huntj88/MicroLights/Casing/casingPrint2Pieces.FCStd

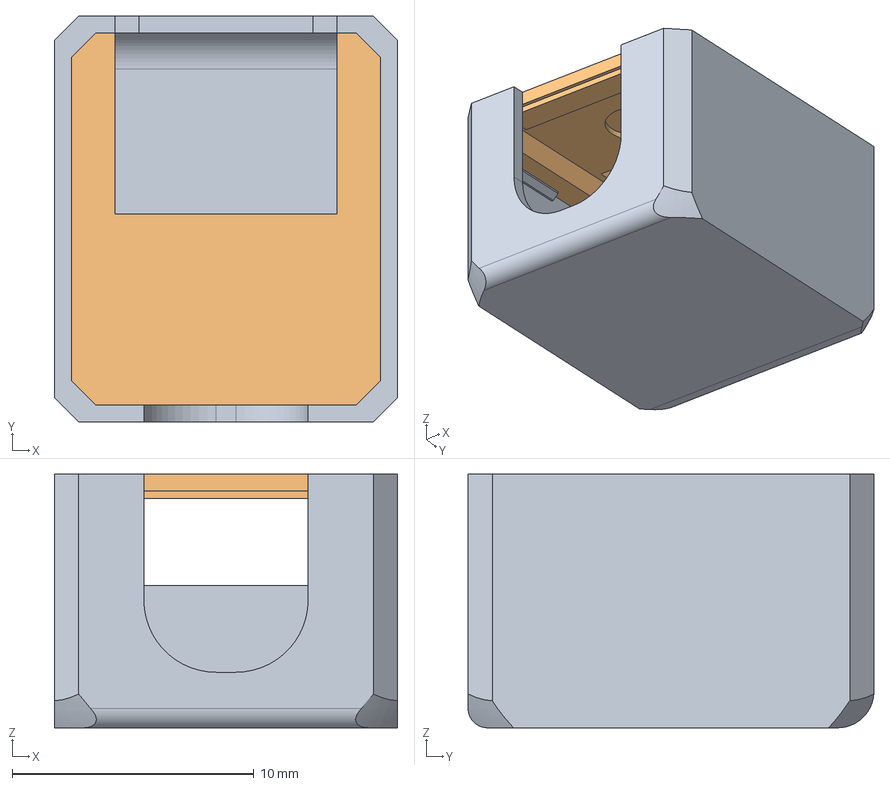
[picture p1: CAD file, 2026-05-08]
Casing/casingPrint2Pieces.FCStd
14.2 x 16.8 x 10.5 mm
