huntj88/MicroLights/Casing/casingPrint2Pieces-bottomCasing17.3mf

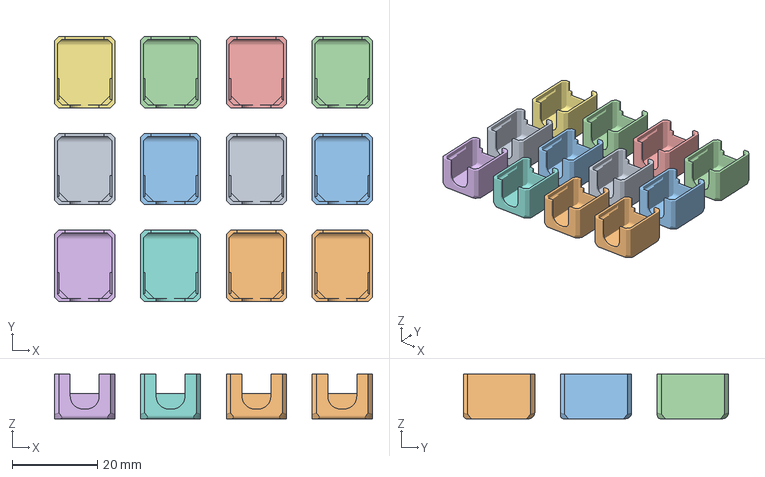
[picture p2: CAD file, 2026-05-08]
Casing/casingPrint2Pieces-bottomCasing17.3mf
74.8 x 62.4 x 10.5 mm
