huntj88/MicroLights/Casing/casingPrint2Pieces-topCasing17.3mf

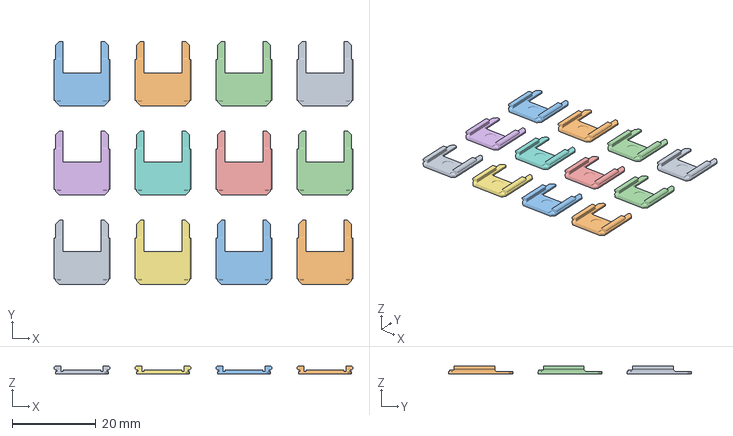
[picture p3: CAD file, 2026-05-08]
Casing/casingPrint2Pieces-topCasing17.3mf
71.6 x 58.2 x 2.00 mm
