huntj88/MicroLights/Casing/JigBendLED.FCStd

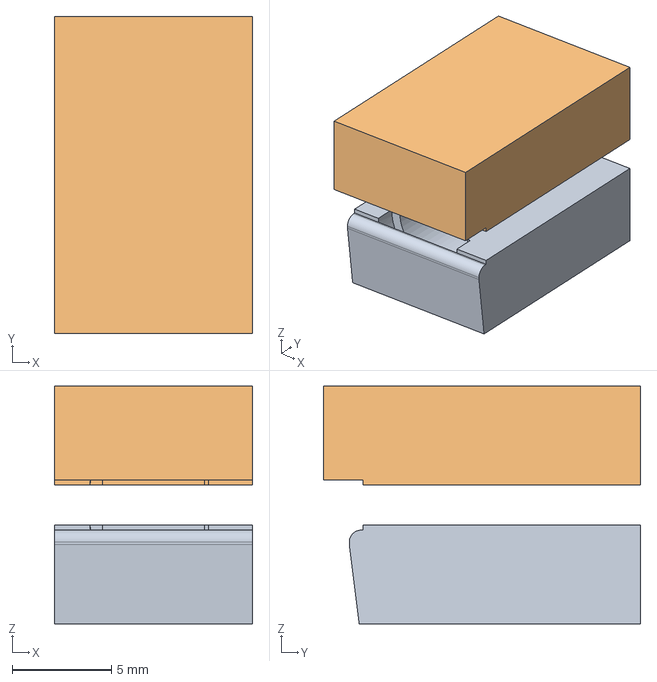
[picture p4: CAD file, 2026-05-04]
Casing/JigBendLED.FCStd
10.0 x 16.0 x 12.0 mm
