huntj88/MicroLights/Casing/bulbJig.FCStd

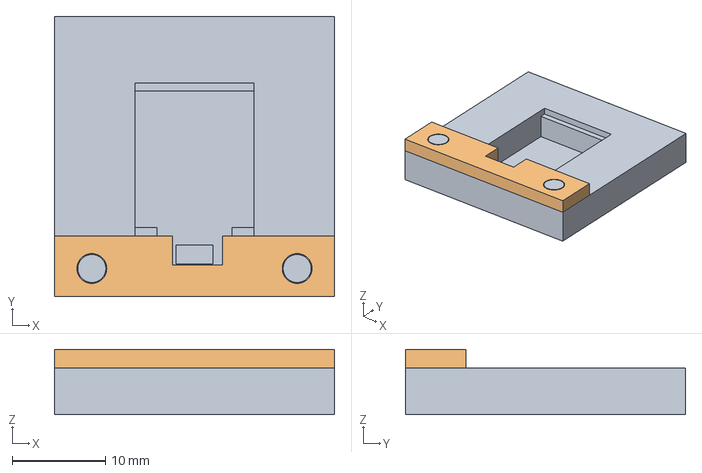
[picture p5: CAD file, 2026-05-04]
Casing/bulbJig.FCStd
30.0 x 30.0 x 7.00 mm
