huntj88/MicroLights/Casing/CasingMoldV2.FCStd

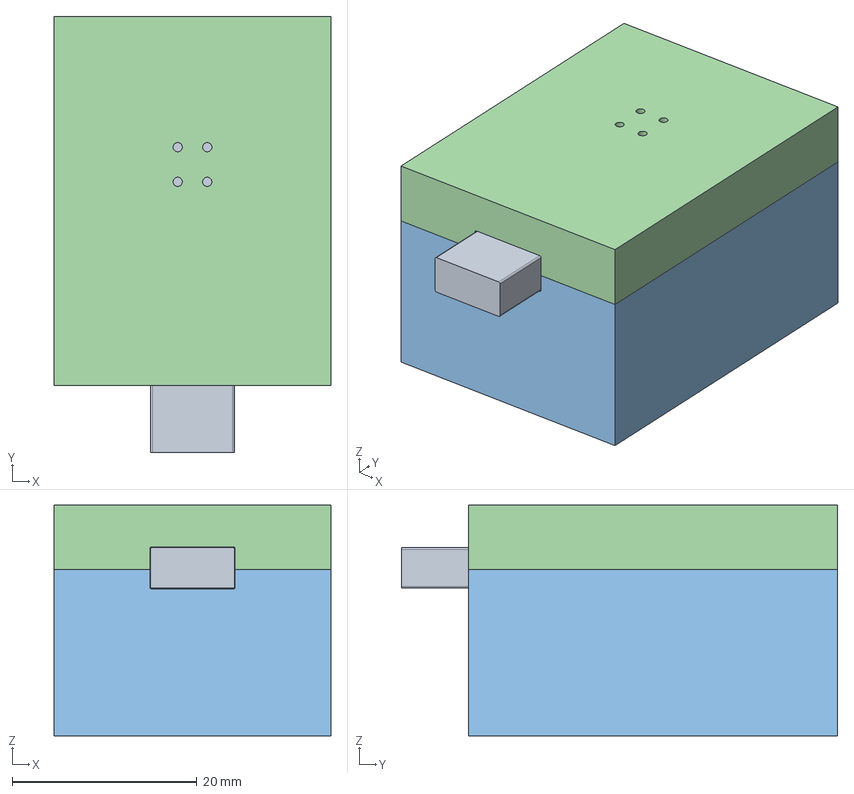
[picture p6: CAD file, 2025-08-21]
Casing/CasingMoldV2.FCStd
30.0 x 47.2 x 25.0 mm
