huntj88/MicroLights/Casing/CasingMold.FCStd

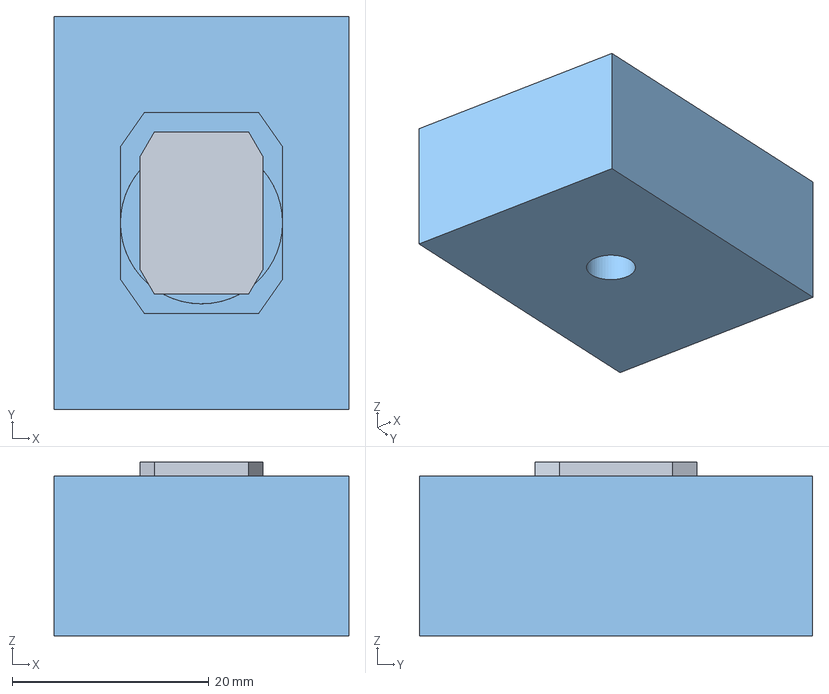
[picture p7: CAD file, 2025-08-16, an earlier design]
Casing/CasingMold.FCStd
30.0 x 40.0 x 17.7 mm
