huntj88/MicroLights/(list of files, cad)

Other CAD files:
Casing/casingPrint2Pieces-bottomCasing17.stl
Casing/casingPrint2Pieces-topCasing17.stl
