huntj88/MicroLights/MicroLightDevBoardV3/MicroLightDevBoardV3.kicad_pcb

## KiCad design MicroLightDevBoardV3/MicroLightDevBoardV3.kicad_pcb (2026-04-19)

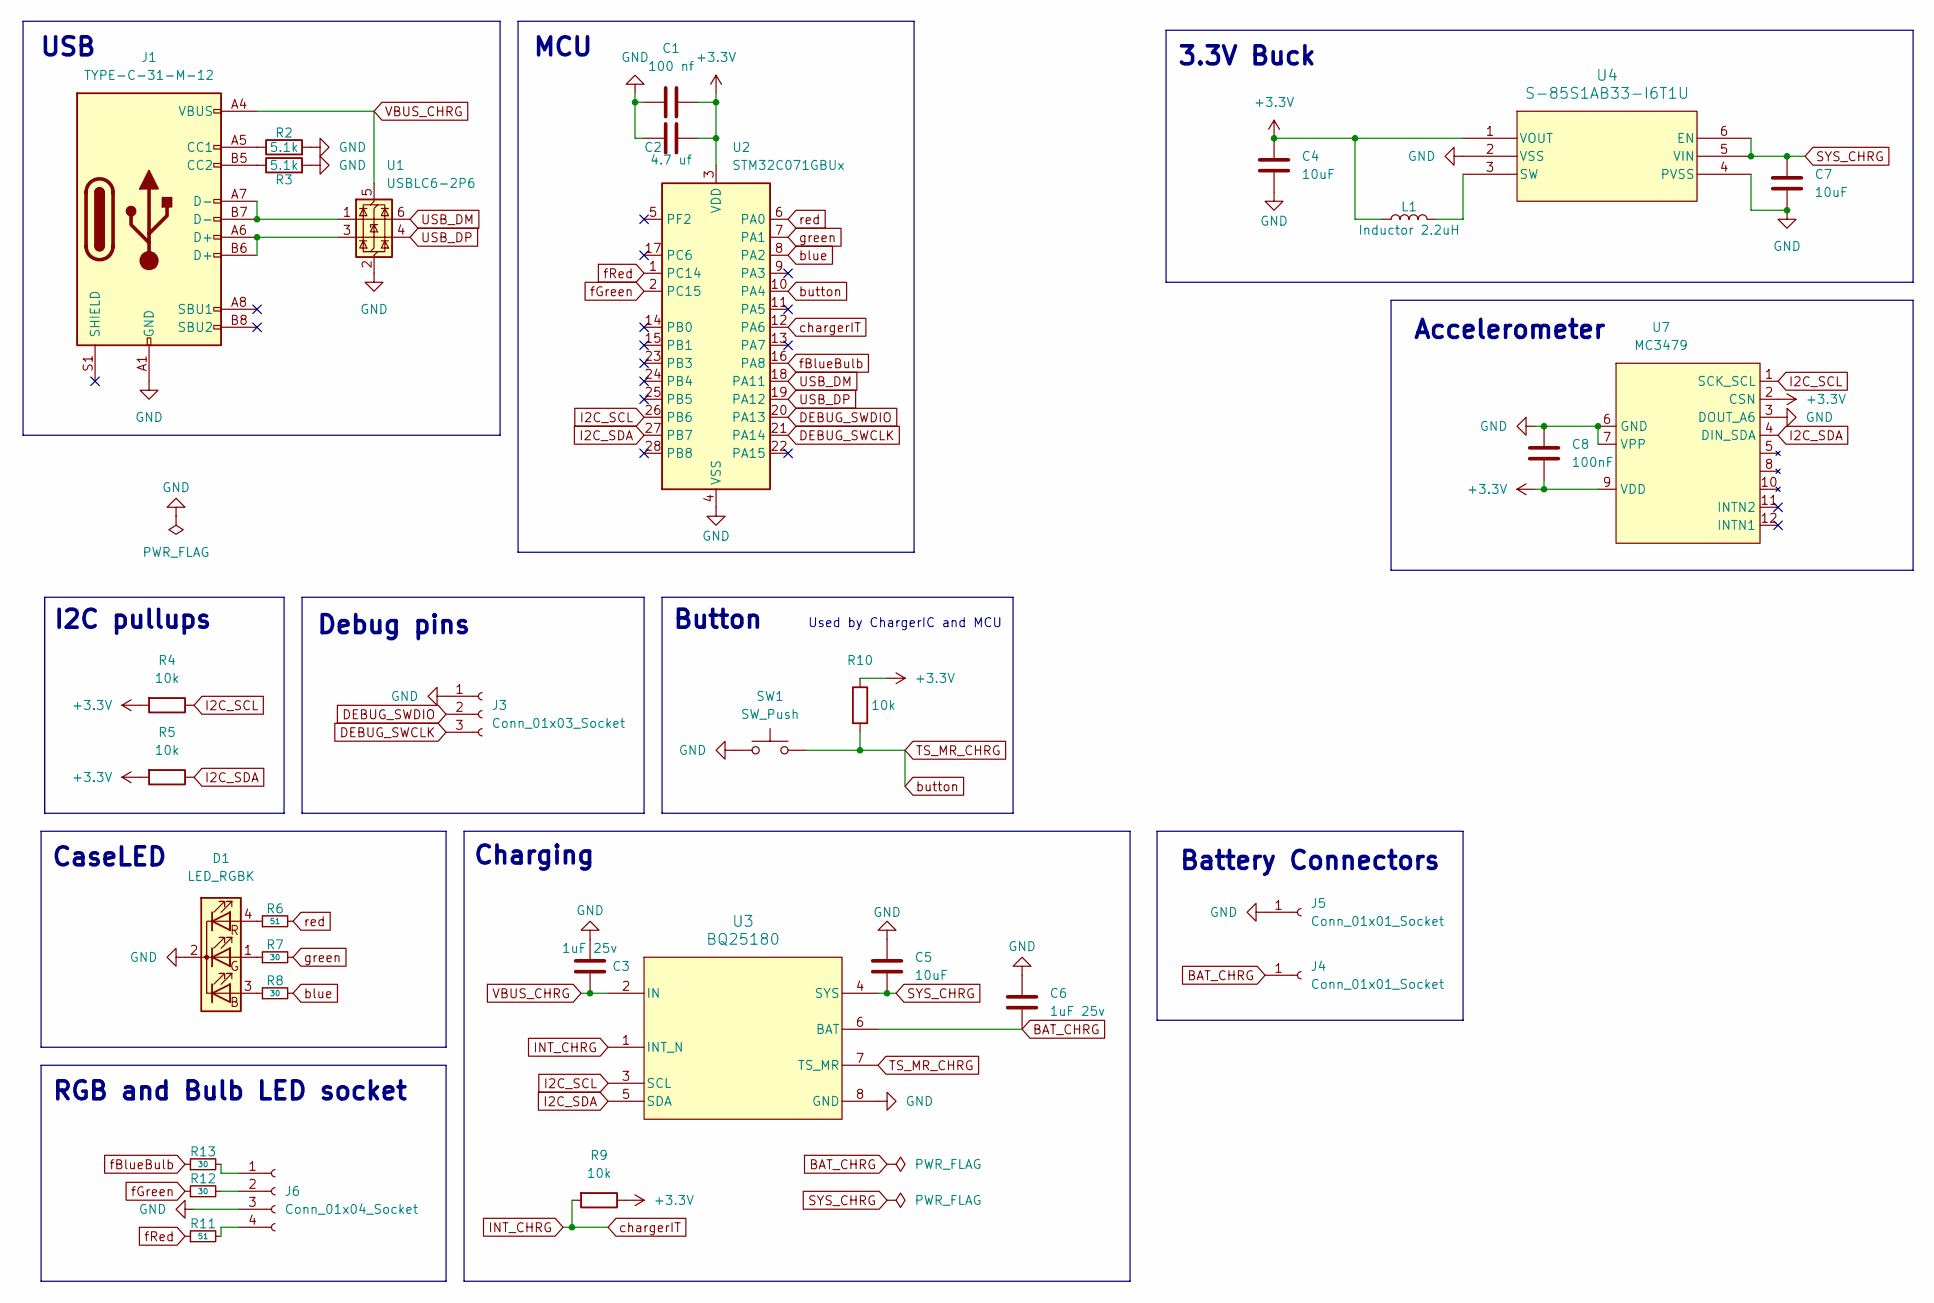
[picture p8: schematic MicroLightDevBoardV3.kicad_sch]

Parts:
C1: 100 nf; C_0402_1005Metric; LCSC C1525
C2: 4.7 uf; C_0402_1005Metric; LCSC C23733
C3, C6: 1uF 25v; C_0402_1005Metric; LCSC C52923
C4, C5, C7: 10uF; C_0402_1005Metric; LCSC C15525
C8: 100nF; C_0402_1005Metric; LCSC C1525
D1: LED_RGBK; RS-C1415MBAR; LCSC C2874181
J1: TYPE-C-31-M-12; USB_C_Receptacle_Hroparts_TYPE-C-31-M-12; LCSC C165948
J3: Conn_01x03_Socket; Microlight_debug_pins
J4, J5: Conn_01x01_Socket; battery_1x01_Vertical
J6: Conn_01x04_Socket; rgbLed4Pin_1.27mm
L1: Inductor 2.2uH; 74438343022_L; LCSC C337891
R2, R3: 5.1k; R_0402_1005Metric; LCSC C25905
R4, R5, R9, R10: 10k; R_0402_1005Metric; LCSC C25744
R6, R11: 51; R_0402_1005Metric; LCSC C25125
R7, R8, R12, R13: 30; R_0402_1005Metric; LCSC C270617
SW1: SW_Push; TS-1089S-02526; LCSC C455282
U1: USBLC6-2P6; SOT-666; LCSC C3647099
U2: STM32C071GBUx; QFN-28_4x4mm_P0.5mm; LCSC C42113261
U3: BQ25180; LCSC C3682423
U4: S-85S1AB33-I6T1U; SNT-6A-A-PKG_PG006-A-P-SD-2.1_ABL; LCSC C7070110
U7: MC3479; LGA-12_2x2mm_P0.5mm

Connections:
+3.3V: C1.1, C2.1, C4.1, C8.2, L1.1, R4.2, R5.2, R9.1, R10.1, U2.3 (VDD), U4.1 (VOUT), U7.2 (CSN), U7.9 (VDD)
BAT_CHRG: C6.2, J4.1, U3.6 (BAT)
DEBUG_SWCLK: J3.3, U2.21 (PA14)
DEBUG_SWDIO: J3.2, U2.20 (PA13)
GND: C1.2, C2.2, C3.1, C4.2, C5.1, C6.1, C7.2, C8.1, D1.2 (K), J1.A1 (GND), J1.B1 (GND), J3.1, J5.1, J6.3, R2.2, R3.2, SW1.1, U1.2 (GND), U2.4 (VSS), U3.8 (GND), U4.2 (VSS), U4.4 (PVSS), U7.3 (DOUT_A6), U7.6 (GND), U7.7 (VPP)
I2C_SCL: R4.1, U2.26 (PB6), U3.3 (SCL), U7.1 (SCK_SCL)
I2C_SDA: R5.1, U2.27 (PB7), U3.5 (SDA), U7.4 (DIN_SDA)
INT_CHRG: R9.2, U2.12 (PA6), U3.1 (INT_N)
unnamed: D1.3 (BA), R8.1
unnamed: D1.1 (GA), R7.1
unnamed: D1.4 (RA), R6.1
unnamed: J1.A5 (CC1), R2.1
unnamed: J1.B5 (CC2), R3.1
unnamed: J1.A6 (D+), J1.B6 (D+), U1.3 (I/O2)
unnamed: J1.A7 (D-), J1.B7 (D-), U1.1 (I/O1)
unnamed: J6.1, R13.2
unnamed: J6.2, R12.2
unnamed: J6.4, R11.2
unnamed: L1.2, U4.3 (SW)
SYS_CHRG: C5.2, C7.1, U3.4 (SYS), U4.5 (VIN), U4.6 (EN)
TS_MR_CHRG: R10.2, SW1.2, U2.10 (PA4), U3.7 (TS_MR)
USB_DM: U1.6 (I/O1), U2.18 (PA11)
USB_DP: U1.4 (I/O2), U2.19 (PA12)
VBUS_CHRG: C3.2, J1.A4 (VBUS), J1.B4 (VBUS), U1.5 (VBUS), U3.2 (IN)
blue: R8.2, U2.8 (PA2)
fBlueBulb: R13.1, U2.16 (PA8)
fGreen: R12.1, U2.2 (PC15)
fRed: R11.1, U2.1 (PC14)
green: R7.2, U2.7 (PA1)
red: R6.2, U2.6 (PA0)

Notes on the sheet:
Used by ChargerIC and MCU
I2C pullups
CaseLED
RGB and Bulb LED socket
USB
Charging
3.3V Buck
Accelerometer
Battery Connectors
Debug pins
Button
MCU

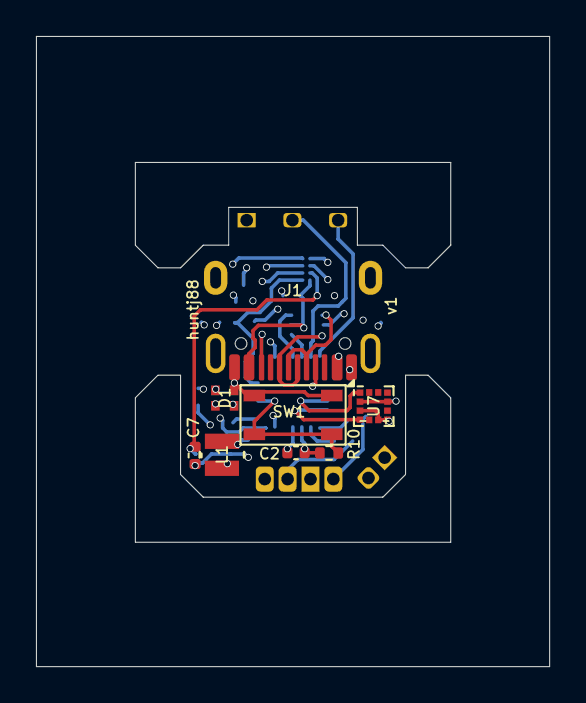
[picture p9: board MicroLightDevBoardV3.kicad_pcb from above]

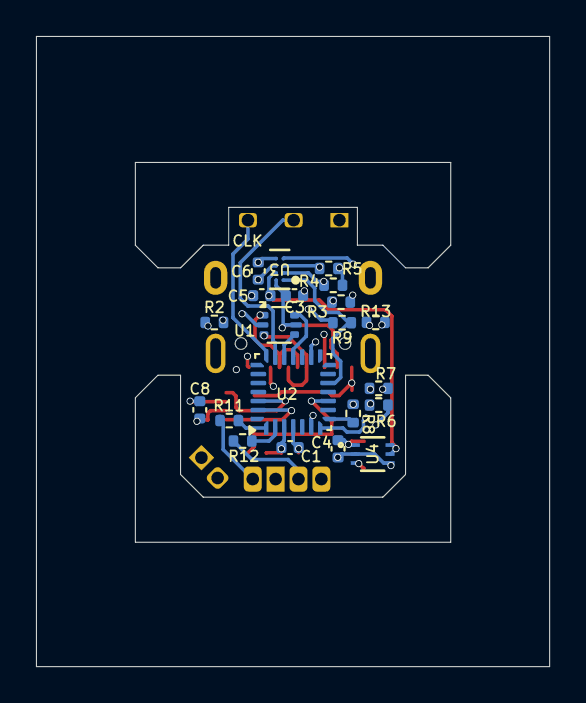
[picture p10: board MicroLightDevBoardV3.kicad_pcb from below]

Board: 6 copper layers, 28.5 x 35.0 mm, 33 parts (21 on the bottom side), 30 nets.
