huntj88/MicroLights/BQ25180PCB/BQ25180PCB.kicad_pcb

## KiCad design BQ25180PCB/BQ25180PCB.kicad_pcb (2024-11-12)

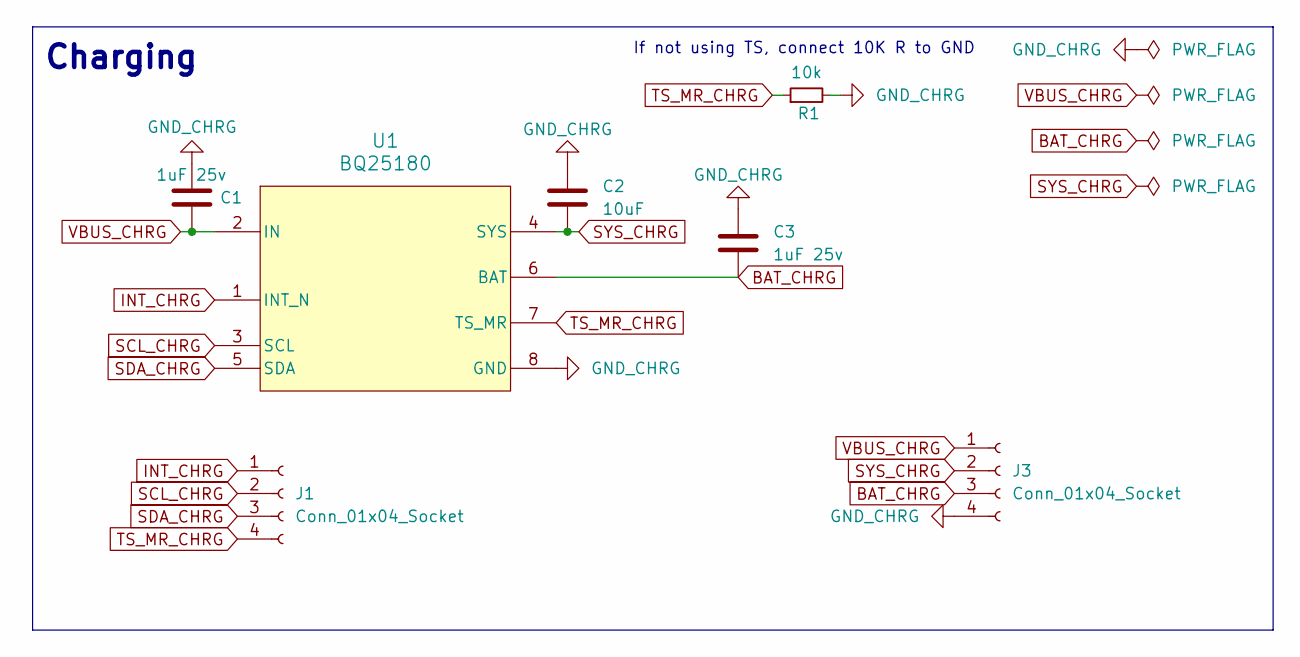
[picture p11: schematic BQ25180PCB.kicad_sch]

Parts:
C1, C3: 1uF 25v; C_0805_2012Metric; LCSC C1712
C2: 10uF; C_0805_2012Metric; LCSC C15850
J1, J3: Conn_01x04_Socket; PinSocket_1x04_P2.54mm_Vertical; LCSC C2718488
R1: 10k; R_0805_2012Metric; LCSC C17414
U1: BQ25180; LCSC C3682423

Connections:
BAT_CHRG: C3.2, J3.3, U1.6 (BAT)
GND_CHRG: C1.1, C2.1, C3.1, J3.4, R1.2, U1.8 (GND)
INT_CHRG: J1.1, U1.1 (INT_N)
SCL_CHRG: J1.2, U1.3 (SCL)
SDA_CHRG: J1.3, U1.5 (SDA)
SYS_CHRG: C2.2, J3.2, U1.4 (SYS)
TS_MR_CHRG: J1.4, R1.1, U1.7 (TS_MR)
VBUS_CHRG: C1.2, J3.1, U1.2 (IN)

Notes on the sheet:
If not using TS, connect 10K R to GND
Charging

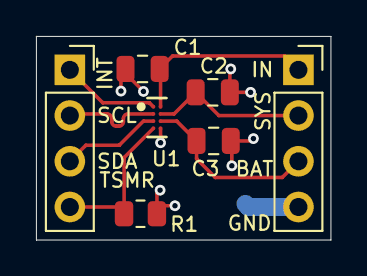
[picture p12: board BQ25180PCB.kicad_pcb from above]

Board: 2 copper layers, 16.4 x 11.3 mm, 7 parts (0 on the bottom side), 8 nets.
