huntj88/MicroLights/MicroLightDevBoardV2/MicroLightDevBoardV2.kicad_pcb

## KiCad design MicroLightDevBoardV2/MicroLightDevBoardV2.kicad_pcb (2024-09-16, an earlier design)

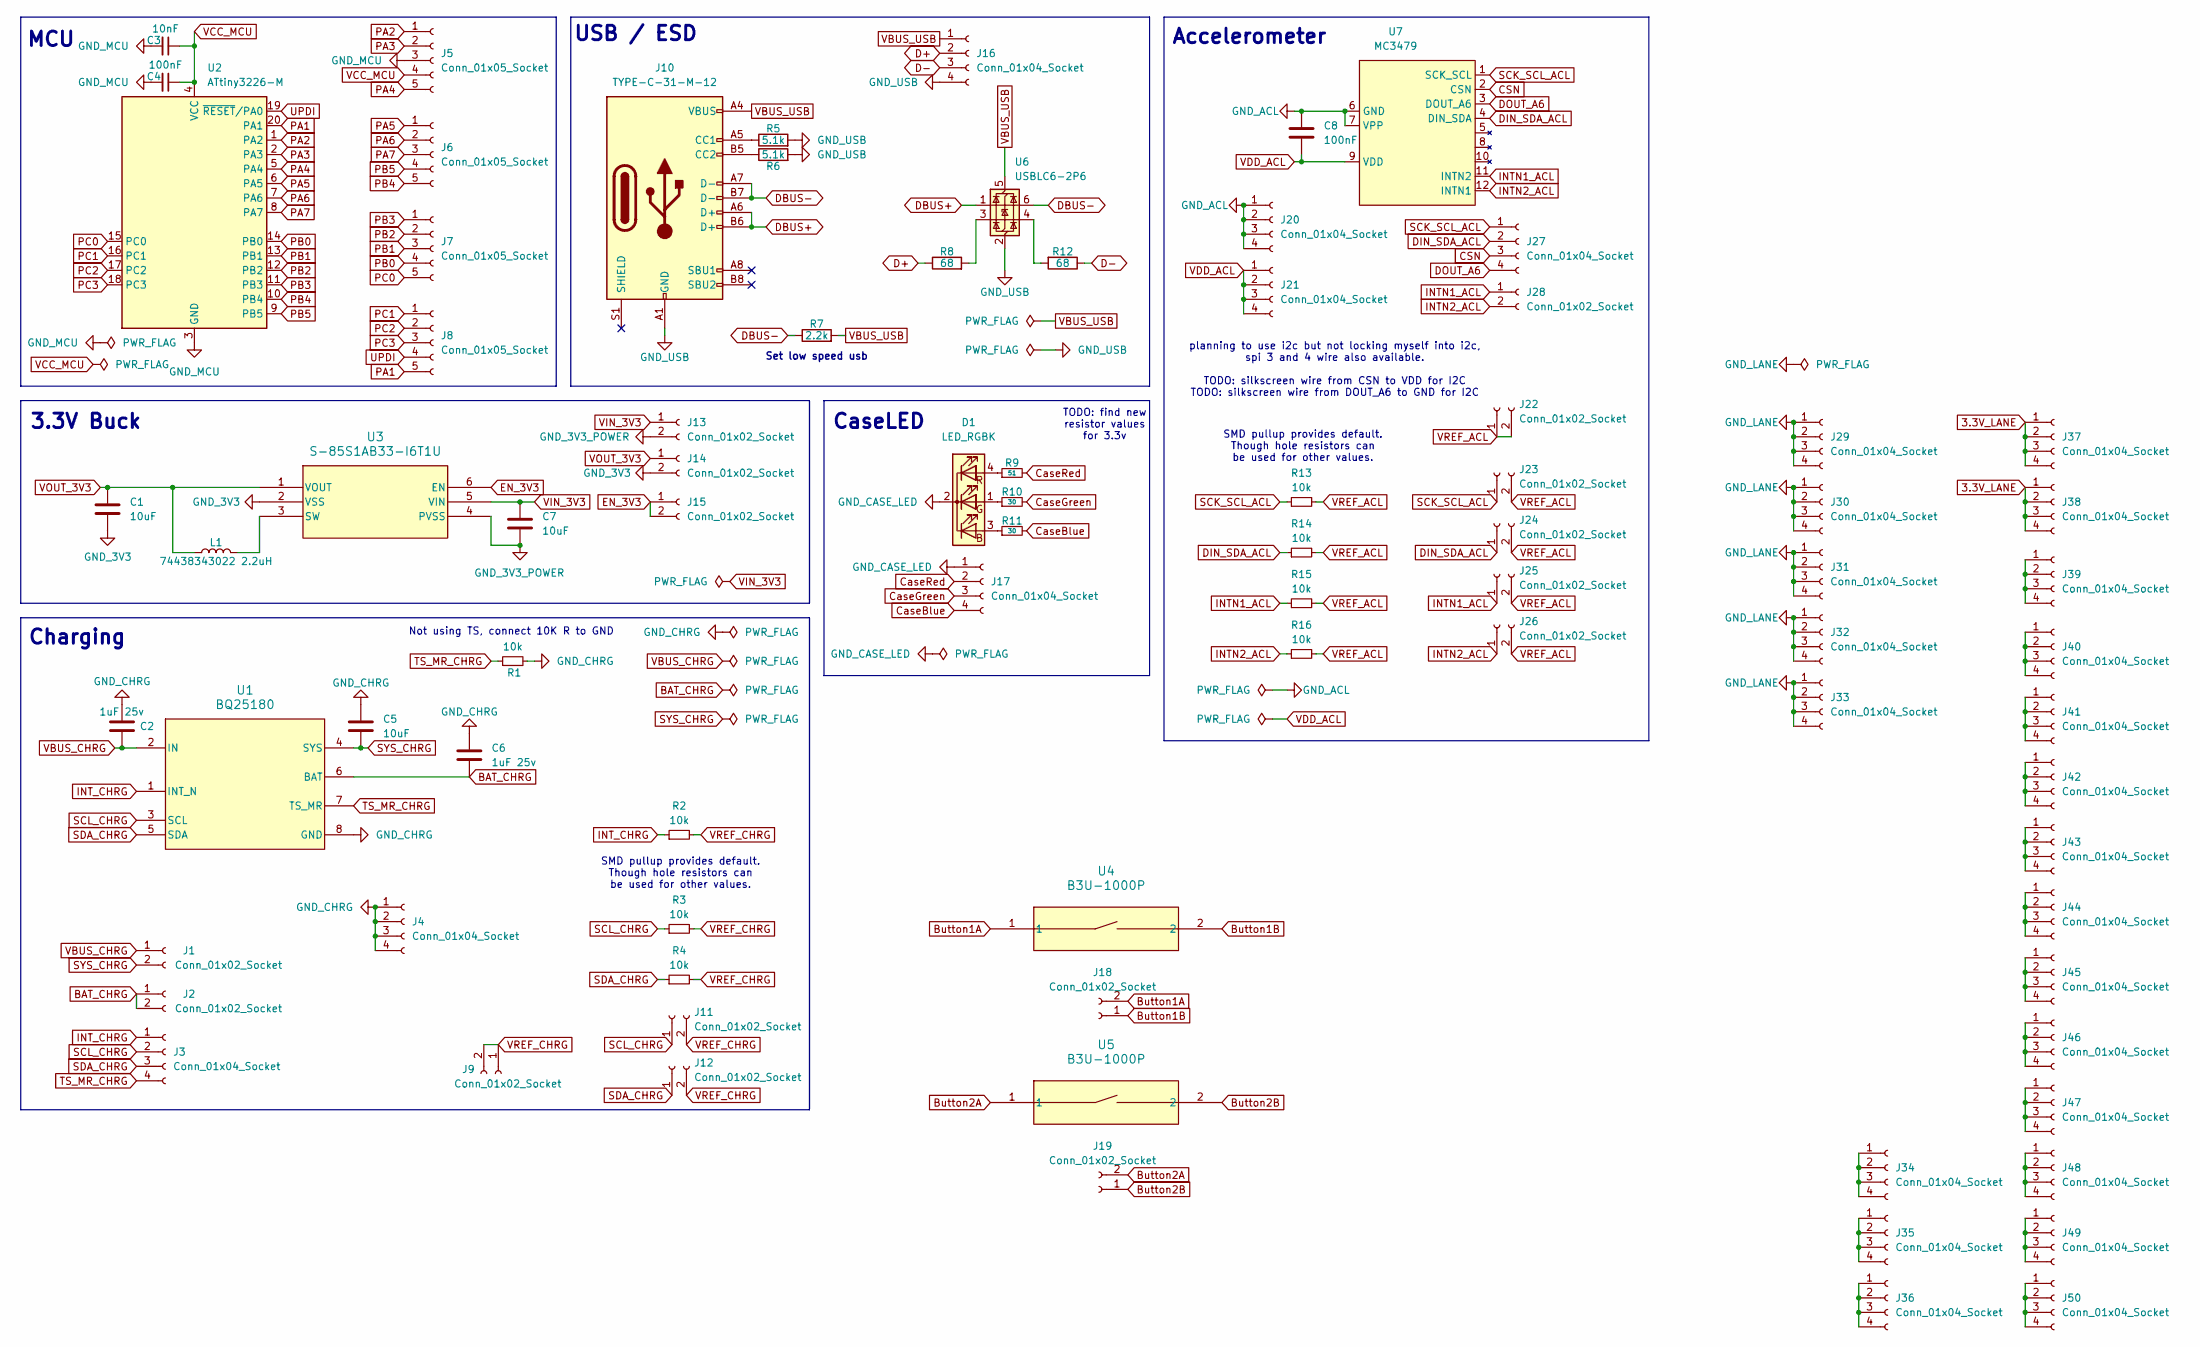
[picture p13: schematic MicroLightDevBoardV2.kicad_sch]

Parts:
C1, C5, C7: 10uF; C_0603_1608Metric; LCSC C96446
C2, C6: 1uF 25v; C_0603_1608Metric; LCSC C15849
C3: 10nF; C_0603_1608Metric; LCSC C57112
C4, C8: 100nF; C_0603_1608Metric; LCSC C14663
D1: LED_RGBK; RS-C1415MBAR; LCSC C2874181
J1, J2, J9, J11, J12, J13, J14, J15, J18, J19, J22, J23, J24, J25, J26, J28: Conn_01x02_Socket; PinSocket_1x02_P2.54mm_Vertical; LCSC C49661
J3, J4, J16, J17, J20, J21, J27, J29, J30, J31, J32, J33, J34, J35, J36, J37, J38, J39, J40, J41, J42, J43, J44, J45, J46, J47, J48, J49, J50: Conn_01x04_Socket; PinSocket_1x04_P2.54mm_Vertical; LCSC C2718488
J5, J6, J7, J8: Conn_01x05_Socket; PinSocket_1x05_P2.54mm_Vertical; LCSC C50950
J10: TYPE-C-31-M-12; USB_C_Receptacle_Hroparts_TYPE-C-31-M-12; LCSC C165948
L1: 74438343022 2.2uH; 74438343022_L
R1, R2, R3, R4, R13, R14, R15, R16: 10k; R_0603_1608Metric; LCSC C25804
R5, R6: 5.1k; R_0603_1608Metric; LCSC C23186
R7: 2.2k; R_0603_1608Metric; LCSC C4190
R8, R12: 68; R_0603_1608Metric; LCSC C27592
R9: 51; R_0603_1608Metric; LCSC C23197
R10, R11: 30; R_0603_1608Metric; LCSC C23140
U1: BQ25180; LCSC C3682423
U2: ATtiny3226-M; VQFN-20-1EP_3x3mm_P0.4mm_EP1.7x1.7mm
U3: S-85S1AB33-I6T1U; SNT-6A-A-PKG_PG006-A-P-SD-2.1_ABL
U4, U5: B3U-1000P; LCSC C231329
U6: USBLC6-2P6; SOT-666; LCSC C15999
U7: MC3479; LGA-12_2x2mm_P0.5mm

Connections:
3.3V_LANE: J37.1, J37.2, J37.3, J37.4, J38.1, J38.2, J38.3, J38.4
BAT_CHRG: C6.2, J2.1, J2.2, U1.6 (BAT)
Button1A: J18.2, U4.1
Button1B: J18.1, U4.2
Button2A: J19.2, U5.1
Button2B: J19.1, U5.2
CSN: J27.3, U7.2 (CSN)
CaseBlue: J17.4, R11.2
CaseGreen: J17.3, R10.2
CaseRed: J17.2, R9.2
D+: J16.2, R8.1
D-: J16.3, R12.1
DBUS+: J10.A6 (D+), J10.B6 (D+), U6.1 (I/O1)
DBUS-: J10.A7 (D-), J10.B7 (D-), R7.1, U6.6 (I/O1)
DIN_SDA_ACL: J24.1, J27.2, R14.1, U7.4 (DIN_SDA)
DOUT_A6: J27.4, U7.3 (DOUT_A6)
EN_3V3: J15.1, J15.2, U3.6 (EN)
GND_3V3: C1.2, J14.2, U3.2 (VSS)
GND_3V3_POWER: C7.2, J13.2, U3.4 (PVSS)
GND_ACL: C8.1, J20.1, J20.2, J20.3, J20.4, U7.6 (GND), U7.7 (VPP)
GND_CASE_LED: D1.2 (K), J17.1
GND_CHRG: C2.1, C5.1, C6.1, J4.1, J4.2, J4.3, J4.4, R1.2, U1.8 (GND)
GND_LANE: J29.1, J29.2, J29.3, J29.4, J30.1, J30.2, J30.3, J30.4, J31.1, J31.2, J31.3, J31.4, J32.1, J32.2, J32.3, J32.4, J33.1, J33.2, J33.3, J33.4
GND_MCU: C3.2, C4.2, J5.3, U2.3 (GND), U2.21 (GND)
GND_USB: J10.A1 (GND), J10.B1 (GND), J16.4, R5.2, R6.2, U6.2 (GND)
INTN1_ACL: J25.1, J28.1, R15.1, U7.11 (INTN2)
INTN2_ACL: J26.1, J28.2, R16.1, U7.12 (INTN1)
INT_CHRG: J3.1, R2.1, U1.1 (INT_N)
unnamed: D1.3 (BA), R11.1
unnamed: D1.1 (GA), R10.1
unnamed: D1.4 (RA), R9.1
unnamed: J10.A5 (CC1), R5.1
unnamed: J10.B5 (CC2), R6.1
unnamed: J34.1, J34.2, J34.3, J34.4
unnamed: J35.1, J35.2, J35.3, J35.4
unnamed: J36.1, J36.2, J36.3, J36.4
unnamed: J39.1, J39.2, J39.3, J39.4
unnamed: J40.1, J40.2, J40.3, J40.4
unnamed: J41.1, J41.2, J41.3, J41.4
unnamed: J42.1, J42.2, J42.3, J42.4
unnamed: J43.1, J43.2, J43.3, J43.4
unnamed: J44.1, J44.2, J44.3, J44.4
unnamed: J45.1, J45.2, J45.3, J45.4
unnamed: J46.1, J46.2, J46.3, J46.4
unnamed: J47.1, J47.2, J47.3, J47.4
unnamed: J48.1, J48.2, J48.3, J48.4
unnamed: J49.1, J49.2, J49.3, J49.4
unnamed: J50.1, J50.2, J50.3, J50.4
unnamed: R8.2, U6.3 (I/O2)
unnamed: R12.2, U6.4 (I/O2)
unnamed: L1.2, U3.3 (SW)
PA1: J8.5, U2.20 (PA1)
PA2: J5.1, U2.1 (PA2)
PA3: J5.2, U2.2 (PA3)
PA4: J5.5, U2.5 (PA4)
PA5: J6.1, U2.6 (PA5)
PA6: J6.2, U2.7 (PA6)
PA7: J6.3, U2.8 (PA7)
PB0: J7.4, U2.14 (PB0)
PB1: J7.3, U2.13 (PB1)
PB2: J7.2, U2.12 (PB2)
PB3: J7.1, U2.11 (PB3)
PB4: J6.5, U2.10 (PB4)
PB5: J6.4, U2.9 (PB5)
PC0: J7.5, U2.15 (PC0)
PC1: J8.1, U2.16 (PC1)
PC2: J8.2, U2.17 (PC2)
PC3: J8.3, U2.18 (PC3)
SCK_SCL_ACL: J23.1, J27.1, R13.1, U7.1 (SCK_SCL)
SCL_CHRG: J3.2, J11.1, R3.1, U1.3 (SCL)
SDA_CHRG: J3.3, J12.1, R4.1, U1.5 (SDA)
SYS_CHRG: C5.2, J1.2, U1.4 (SYS)
TS_MR_CHRG: J3.4, R1.1, U1.7 (TS_MR)
UPDI: J8.4, U2.19 (~RESET/PA0)
VBUS_CHRG: C2.2, J1.1, U1.2 (IN)
VBUS_USB: J10.A4 (VBUS), J10.B4 (VBUS), J16.1, R7.2, U6.5 (VBUS)
VCC_MCU: C3.1, C4.1, J5.4, U2.4 (VCC)
VDD_ACL: C8.2, J21.1, J21.2, J21.3, J21.4, U7.9 (VDD)
VIN_3V3: C7.1, J13.1, U3.5 (VIN)
VOUT_3V3: C1.1, J14.1, L1.1, U3.1 (VOUT)
VREF_ACL: J22.1, J22.2, J23.2, J24.2, J25.2, J26.2, R13.2, R14.2, R15.2, R16.2
VREF_CHRG: J9.1, J9.2, J11.2, J12.2, R2.2, R3.2, R4.2

Notes on the sheet:
MCU
3.3V Buck
SMD pullup provides default. Though hole resistors can be used for other values.
Not using TS, connect 10K R to GND
USB / ESD
Accelerometer
planning to use i2c but not locking myself into i2c, spi 3 and 4 wire also available. TODO: silkscreen wire from CSN to VDD for I2C TODO: silkscreen wire from DOUT_A6 to GND for I2C
TODO: find new resistor values for 3.3v
Set low speed usb
Charging
CaseLED

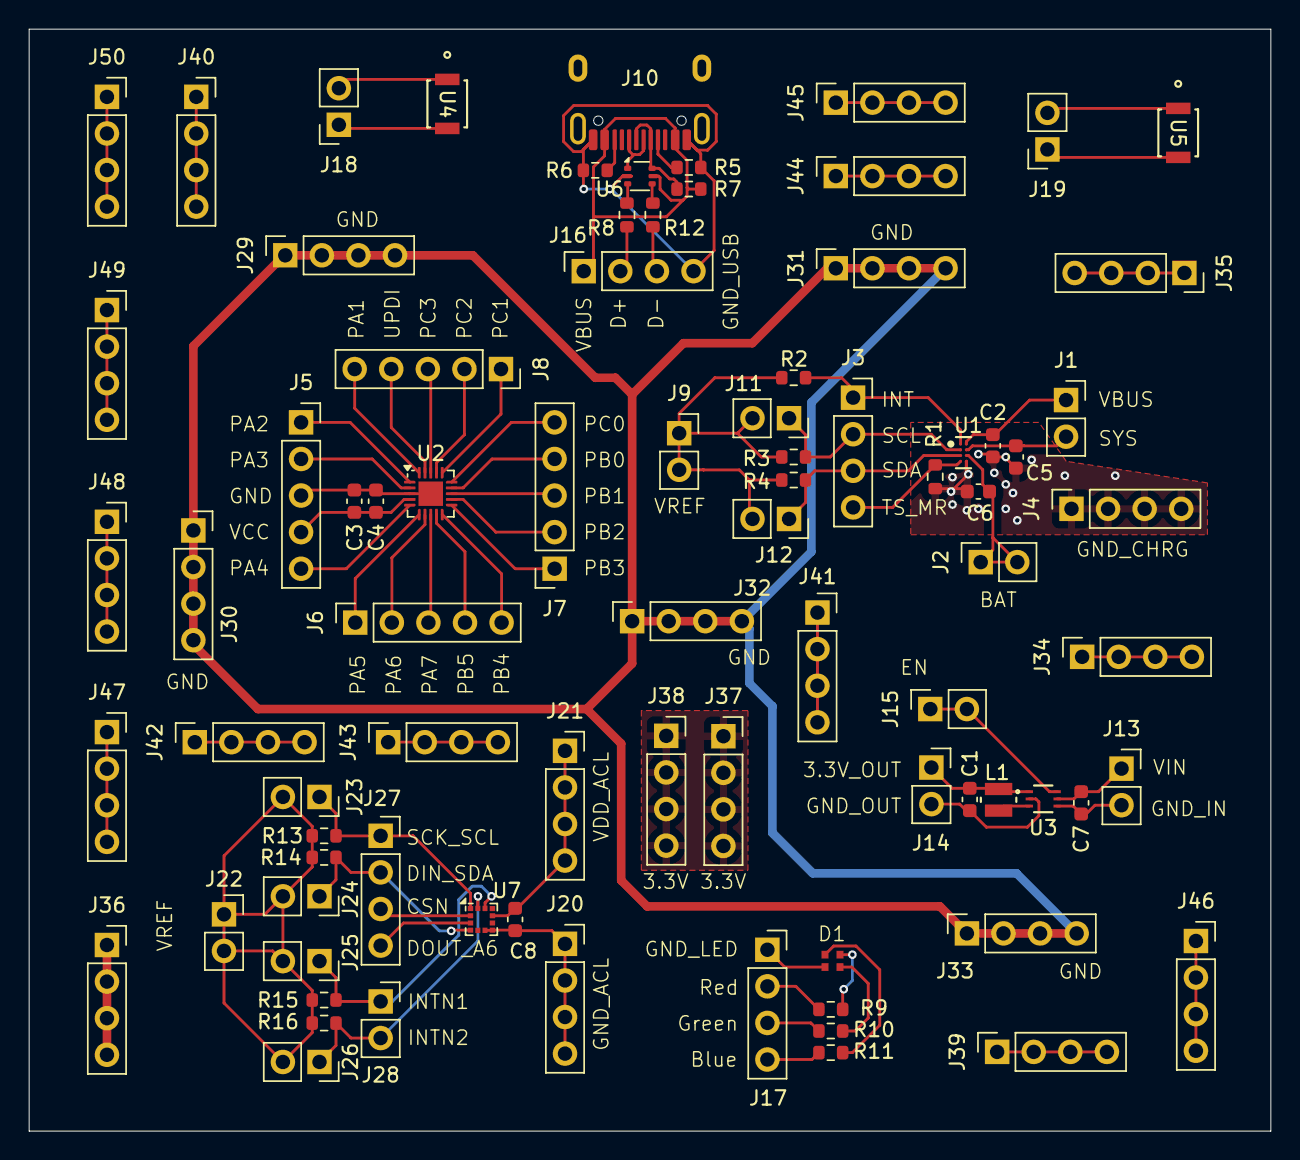
[picture p14: board MicroLightDevBoardV2.kicad_pcb from above]

Board: 2 copper layers, 86.2 x 76.5 mm, 83 parts (0 on the bottom side), 82 nets.
