huntj88/MicroLights/BatteryExperimentPCB/BatteryExperimentPCB.kicad_pcb

## KiCad design BatteryExperimentPCB/BatteryExperimentPCB.kicad_pcb (2024-08-20)

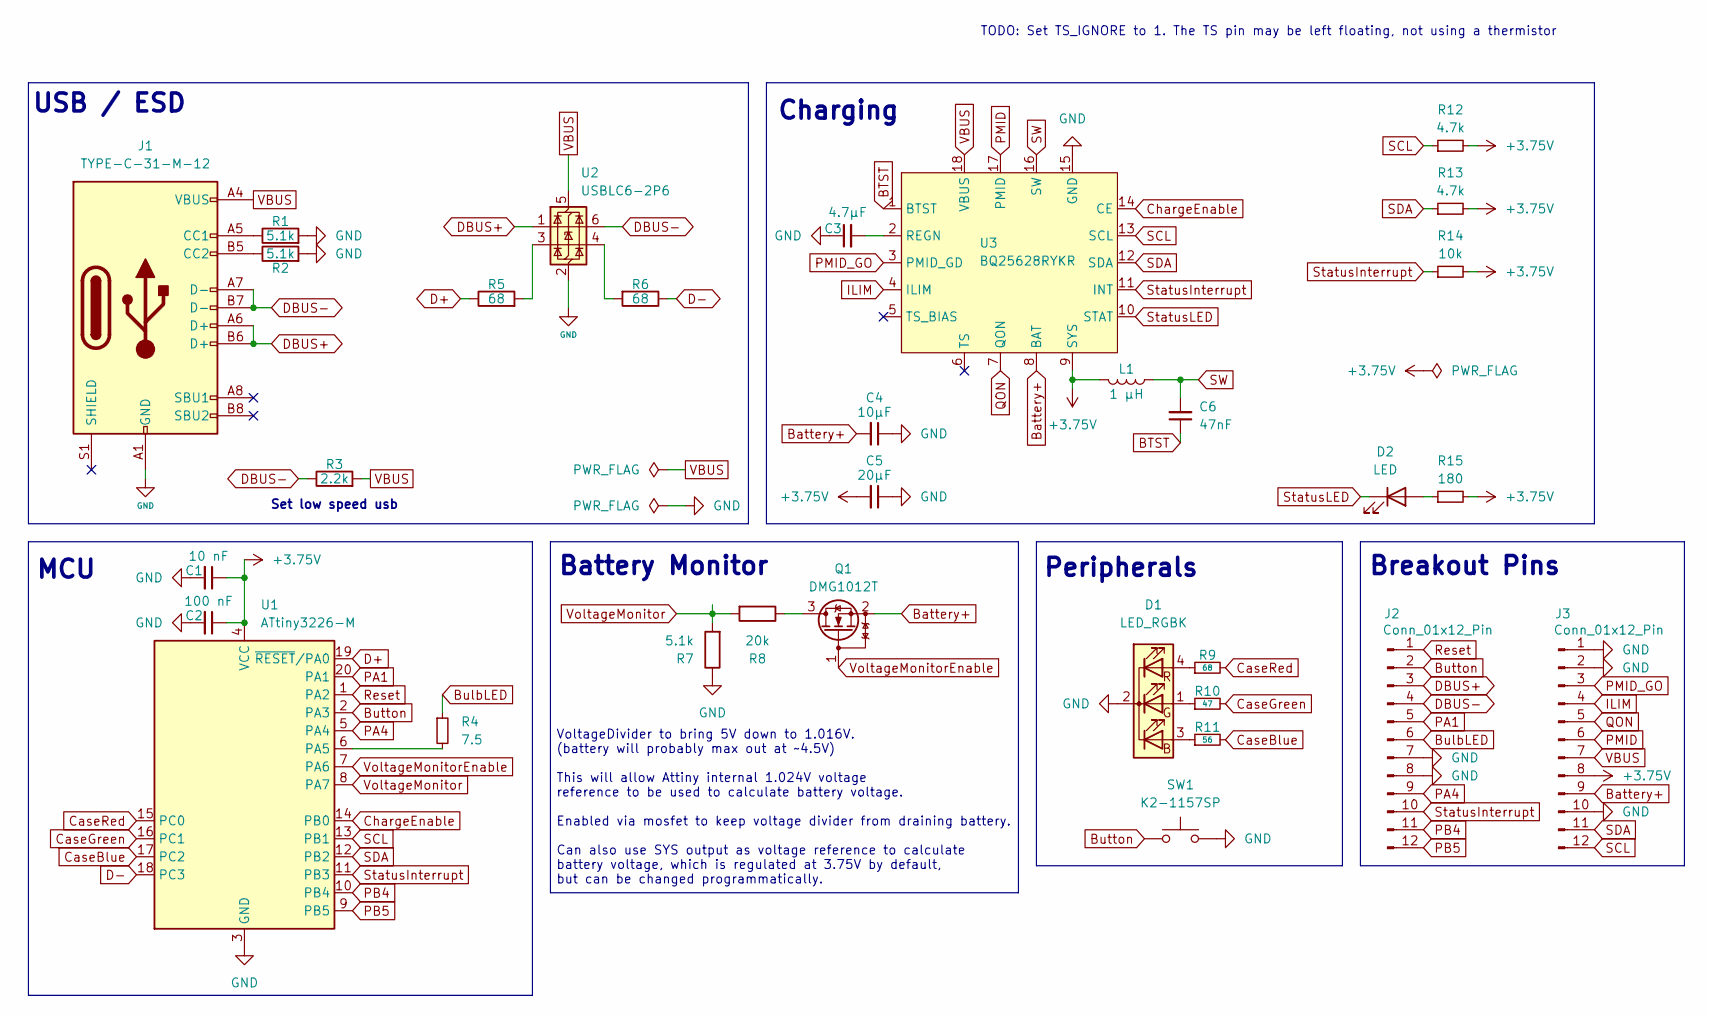
[picture p15: schematic BatteryExperimentPCB.kicad_sch]

Parts:
C1: 10 nF; C_0603_1608Metric
C2: 100 nF; C_0603_1608Metric
C3: 4.7μF; C_0603_1608Metric
C4: 10μF; C_0603_1608Metric
C5: 20μF; C_0603_1608Metric
C6: 47nF; C_0603_1608Metric
D1: LED_RGBK; RS-C1415MBAR
D2: LED; LED_0805_2012Metric
J1: TYPE-C-31-M-12; USB_C_Receptacle_Hroparts_TYPE-C-31-M-12
J2, J3: Conn_01x12_Pin; PinHeader_1x12_P2.54mm_Vertical
L1: 1 μH; L_0805_2012Metric
Q1: DMG1012T; SOT-523
R1, R2, R7: 5.1k; R_0603_1608Metric
R3: 2.2k; R_0603_1608Metric
R4: 7.5; R_0603_1608Metric
R5, R6, R9: 68; R_0603_1608Metric
R8: 20k; R_0603_1608Metric
R10: 47; R_0603_1608Metric
R11: 56; R_0603_1608Metric
R12, R13: 4.7k; R_0603_1608Metric
R14: 10k; R_0603_1608Metric
R15: 180; R_0603_1608Metric
SW1: K2-1157SP
U1: ATtiny3226-M; VQFN-20-1EP_3x3mm_P0.4mm_EP1.7x1.7mm
U2: USBLC6-2P6; SOT-666
U3: BQ25628RYKR; RYK0018A-MFG

Connections:
+3.75V: C1.1, C2.1, C5.2, J3.8, L1.2, R12.2, R13.2, R14.2, R15.2, U1.4 (VCC), U3.9 (SYS)
BTST: C6.1, U3.1 (BTST)
Battery+: C4.2, J3.9, Q1.2 (S), U3.8 (BAT)
BulbLED: J2.6, R4.1
Button: J2.2, SW1.1, U1.2 (PA3)
CaseBlue: R11.2, U1.17 (PC2)
CaseGreen: R10.2, U1.16 (PC1)
CaseRed: R9.2, U1.15 (PC0)
ChargeEnable: U1.14 (PB0), U3.14 (CE)
D+: R5.1, U1.19 (~RESET/PA0)
D-: R6.1, U1.18 (PC3)
DBUS+: J1.A6 (D+), J1.B6 (D+), J2.3, U2.1 (I/O1)
DBUS-: J1.A7 (D-), J1.B7 (D-), J2.4, R3.1, U2.6 (I/O1)
GND: C1.2, C2.2, C3.1, C4.1, C5.1, D1.2 (K), J1.A1 (GND), J1.B1 (GND), J2.7, J2.8, J3.1, J3.2, J3.10, R1.2, R2.2, R7.1, SW1.2, U1.3 (GND), U1.21 (GND), U2.2 (GND), U3.15 (GND)
ILIM: J3.4, U3.4 (ILIM)
unnamed: D1.3 (BA), R11.1
unnamed: D1.1 (GA), R10.1
unnamed: D1.4 (RA), R9.1
unnamed: D2.2 (A), R15.1
unnamed: J1.A5 (CC1), R1.1
unnamed: J1.B5 (CC2), R2.1
unnamed: Q1.3 (D), R8.1
unnamed: R5.2, U2.3 (I/O2)
unnamed: R6.2, U2.4 (I/O2)
unnamed: R4.2, U1.6 (PA5)
unnamed: C3.2, U3.2 (REGN)
PA1: J2.5, U1.20 (PA1)
PA4: J2.9, U1.5 (PA4)
PB4: J2.11, U1.10 (PB4)
PB5: J2.12, U1.9 (PB5)
PMID: J3.6, U3.17 (PMID)
PMID_GO: J3.3, U3.3 (PMID_GD)
QON: J3.5, U3.7 (QON)
Reset: J2.1, U1.1 (PA2)
SCL: J3.12, R12.1, U1.13 (PB1), U3.13 (SCL)
SDA: J3.11, R13.1, U1.12 (PB2), U3.12 (SDA)
SW: C6.2, L1.1, U3.16 (SW)
StatusInterrupt: J2.10, R14.1, U1.11 (PB3), U3.11 (INT)
StatusLED: D2.1 (K), U3.10 (STAT)
VBUS: J1.A4 (VBUS), J1.B4 (VBUS), J3.7, R3.2, U2.5 (VBUS), U3.18 (VBUS)
VoltageMonitor: R7.2, R8.2, U1.8 (PA7)
VoltageMonitorEnable: Q1.1 (G), U1.7 (PA6)

Notes on the sheet:
Peripherals
Set low speed usb
TODO: Set TS_IGNORE to 1. The TS pin may be left floating, not using a thermistor
USB / ESD
MCU
VoltageDivider to bring 5V down to 1.016V. (battery will probably max out at ~4.5V) This will allow Attiny internal 1.024V voltage reference to be used to calculate battery voltage. Enabled via mosfet to keep voltage divider from draining battery. Can also use SYS output as voltage reference to cal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
Charging
Breakout Pins
Battery Monitor

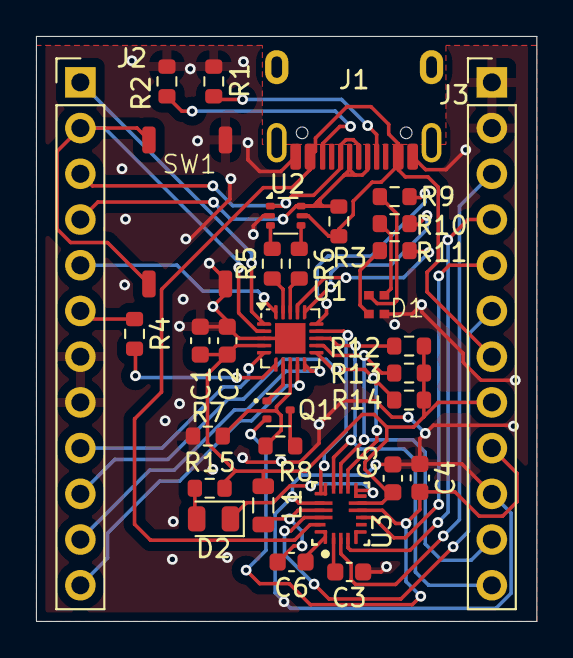
[picture p16: board BatteryExperimentPCB.kicad_pcb from above]

Board: 2 copper layers, 27.8 x 32.5 mm, 32 parts (0 on the bottom side), 42 nets.
