huntj88/MicroLights/BulbChipSTM32C071FBPx/Core/Src/main.c

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
/* Includes ------------------------------------------------------------------*/
#include "main.h"

/* USER CODE BEGIN Includes */
#include "bootloader.h"
#include "mcu_dependencies.h"
#include "microlight/microlight.h"
#include "tusb.h"
#include "usb_dependencies.h"
/* USER CODE END Includes */


I2C_HandleTypeDef hi2c1;

RTC_HandleTypeDef hrtc;

TIM_HandleTypeDef htim1;
TIM_HandleTypeDef htim2;
TIM_HandleTypeDef htim3;
TIM_HandleTypeDef htim17;

PCD_HandleTypeDef hpcd_USB_DRD_FS;

void SystemClock_Config(void);
static void MX_GPIO_Init(void);
static void MX_I2C1_Init(void);
static void MX_USB_PCD_Init(void);
static void MX_TIM1_Init(void);
static void MX_TIM2_Init(void);
static void MX_TIM3_Init(void);
static void MX_TIM17_Init(void);
static void MX_RTC_Init(void);
/**
 * @brief  The application entry point.
 * @retval int
 */
int main(void) {
    /* USER CODE BEGIN 1 */
    handleBootFlag();
    /* USER CODE END 1 */

    /* MCU Configuration--------------------------------------------------------*/

    /* Reset of all peripherals, Initializes the Flash interface and the Systick. */
    HAL_Init();

    /* Configure the system clock */
    SystemClock_Config();

    /* Initialize all configured peripherals */
    MX_GPIO_Init();
    MX_I2C1_Init();
    MX_USB_PCD_Init();
    MX_TIM1_Init();
    MX_TIM2_Init();
    MX_TIM3_Init();
    MX_TIM17_Init();
    MX_RTC_Init();
    /* USER CODE BEGIN 2 */

    tusb_init();
    // TIM1: case rgb led timer - no interrupts
    // TIM2: chipTick timer - interrupts to increment chipTick
    // TIM3: front rgb led timer - no interrupts
    // TIM17: autoOff timer - interrupts very infrequently when in fake off mode to check time
    static char mainJsonBuffer[PAGE_SECTOR];
    MicroLightDependencies deps = {
        .i2cWriteRegister = i2cWriteRegister,
        .i2cReadRegisters = i2cReadRegisters,
        .writeRgbPwmCaseLed = writeRgbPwmCaseLed,
        .writeRgbPwmFrontLed = writeRgbPwmFrontLed,
        .writeBulbLed = writeBulbLed,
        .readButtonPin = readButtonPin,
        .usbReadTask = usbReadTask,
        .usbWrite = usbWrite,
        .readSavedSettings = readSettingsFromFlash,
        .saveSettings = writeSettingsToFlash,
        .readSavedMode = readModeFromFlash,
        .saveMode = writeModeToFlash,
        .enableChipTickTimer = enableChipTickTimer,
        .enableCaseLedTimer = enableCaseLedTimer,
        .enableFrontLedTimer = enableFrontLedTimer,
        .enableAutoOffTimer = enableAutoOffTimer,
        .enableUsbClock = enableUsbClock,
        .enterStandbyMode = enterStandbyMode,
        .waitForButtonWakeOrAutoLock = waitForButtonWakeOrAutoLock,
        .systemReset = NVIC_SystemReset,
        .enterDFU = setBootloaderFlagAndReset,
        .convertTicksToMilliseconds = convertTicksToMilliseconds,
        .rgbTimerPeriod = htim1.Init.Period,
        .jsonBuffer = mainJsonBuffer,
        .jsonBufferSize = sizeof(mainJsonBuffer)};

    if (htim1.Init.Period != htim3.Init.Period || htim1.Init.Prescaler != htim3.Init.Prescaler) {
        Error_Handler();
    }

    if (!configureMicroLight(&deps)) {
        Error_Handler();
    }

    /* USER CODE END 2 */

    /* Infinite loop */
    /* USER CODE BEGIN WHILE */

    while (1) {
        microLightTask();

        HAL_SuspendTick();
        HAL_PWR_EnterSLEEPMode(PWR_MAINREGULATOR_ON, PWR_SLEEPENTRY_WFI);
        HAL_ResumeTick();
        /* USER CODE END WHILE */

        /* USER CODE BEGIN 3 */
    }
    /* USER CODE END 3 */
}

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
