huntj88/MicroLights/BulbChipSTM32C071FBPx/BulbChipSTM32C071FBPx.ioc

Mcu.UserName=STM32C071FBPx
PA0.GPIO_Label=red
PA0.Signal=S_TIM1_CH1
PA1.GPIO_Label=green
PA1.Signal=S_TIM1_CH2
PA13.Signal=DEBUG_SWDIO
PA14-BOOT0.Signal=DEBUG_SWCLK
PA2.GPIO_Label=blue
PA2.Signal=S_TIM1_CH3
PA4.GPIO_Label=button
PA4.Signal=GPXTI4
PA5.GPIO_Label=bulbLed
PA5.Signal=GPIO_Output
PA6.GPIO_Label=chargerIT
PA6.Signal=GPXTI6
PA8.GPIO_Label=fBlue
PA8.Signal=S_TIM3_CH4
PB6.Signal=I2C1_SCL
PB7.Signal=I2C1_SDA
PC14-OSCX_IN(PC14).GPIO_Label=fRed
PC14-OSCX_IN(PC14).Signal=S_TIM3_CH2
PC15-OSCX_OUT(PC15).GPIO_Label=fGreen
PC15-OSCX_OUT(PC15).Signal=S_TIM3_CH3
