huntj88/MicroLights/BulbChipSTM32C071FBPx/Core/Inc/main.h

#define fRed_Pin GPIO_PIN_14
#define fRed_GPIO_Port GPIOC
#define fGreen_Pin GPIO_PIN_15
#define fGreen_GPIO_Port GPIOC
#define red_Pin GPIO_PIN_0
#define red_GPIO_Port GPIOA
#define green_Pin GPIO_PIN_1
#define green_GPIO_Port GPIOA
#define blue_Pin GPIO_PIN_2
#define blue_GPIO_Port GPIOA
#define button_Pin GPIO_PIN_4
#define button_GPIO_Port GPIOA
#define button_EXTI_IRQn EXTI4_15_IRQn
#define bulbLed_Pin GPIO_PIN_5
#define bulbLed_GPIO_Port GPIOA
#define chargerIT_Pin GPIO_PIN_6
#define chargerIT_GPIO_Port GPIOA
#define chargerIT_EXTI_IRQn EXTI4_15_IRQn
#define fBlue_Pin GPIO_PIN_8
#define fBlue_GPIO_Port GPIOA
#define button_Pin GPIO_PIN_7
