huntj88/MicroLights/BulbChipSTM32C071FBPx/Core/Src/rgb.c

/*
 * rgb.c
 *
 *  Created on: Jul 3, 2025
 *      Author: jameshunt
 */

#include <stddef.h>
#include <stdbool.h>
#include "rgb.h"

// TODO: multiple priorities, could create a prioritized led resource mutex if it gets more complicated
// button input
// user defined mode color
// charging

static uint16_t colorRangeToDuty(const RGB *device, uint8_t value) {
	uint16_t increment = device->period / 255U;
	return value * increment;
}

// TODO: move transient side effect to different function
// expect red, green, blue to be in range of 0 to 255
static void showColor(RGB *device, uint8_t red, uint8_t green, uint8_t blue, bool transient) {
	if (!device || !device->writePwm) {
		return;
	}

	device->showingTransientStatus = transient;

	uint16_t scaledRed = colorRangeToDuty(device, red);
	uint16_t scaledGreen = colorRangeToDuty(device, green);
	uint16_t scaledBlue = colorRangeToDuty(device, blue);

	device->writePwm(scaledRed, scaledGreen, scaledBlue);
	device->tickOfColorChange = device->tick;
}

bool rgbInit(RGB *device, RGBWritePwm *writeFn, uint16_t period) {
	if (!device || !writeFn) {
		return false;
	}

	device->writePwm = writeFn;
	device->period = period;

	device->tick = 0;
	device->tickOfColorChange = 0;
	device->showingTransientStatus = false;
	device->userRed = 0;
	device->userGreen = 0;
	device->userBlue = 0;
	return true;
}

static void sinColorRange(uint16_t tick, uint8_t incrementAt, uint8_t *color) {
	if (tick % incrementAt == 0) {
		uint16_t sinCounter = tick / incrementAt;
		double waveProgress = sinCounter / 10.0;
		double zeroToOneY = (sin(waveProgress) + 1.0) / 2.0;
		*color = (uint8_t)(zeroToOneY * 255.0);
	}
}

static bool isRainbowModeExperiment(RGB *device) {
	// TODO: debug parsing to understand why #ffffff is not 255,255,255
	return device->userRed > 240 && device->userGreen > 240 && device->userGreen > 240;
}

static void rainbowModeExperiment(RGB *device, uint16_t tick) {
	static uint8_t r,g,b;

	if (isRainbowModeExperiment(device)) {
		sinColorRange(tick, 11, &r);
		sinColorRange(tick, 17, &g);
		sinColorRange(tick, 23, &b);

		if (tick % 20 == 0) {
			showColor(device, r, g, b, false);
		}
	}
}

void rgbTask(RGB *device, uint16_t tick, float millisPerTick) {
	if (!device) {
		return;
	}

	device->tick = tick;

	uint16_t elapsedMillis = (uint16_t)((tick - device->tickOfColorChange) * millisPerTick);

	// show status color for 300 milliseconds, then switch back to user color
	if (device->showingTransientStatus && elapsedMillis > 300) {
		showColor(device, device->userRed, device->userGreen, device->userBlue, false);
	}

	// just for fun
	rainbowModeExperiment(device, tick);
}

void rgbShowNoColor(RGB *device) {
	rgbShowUserColor(device, 0, 0, 0);
}

void rgbShowUserColor(RGB *device, uint8_t red, uint8_t green, uint8_t blue) {
	if (!device) {
		return;
	}

	device->userRed = red;
	device->userGreen = green;
	device->userBlue = blue;

	// only change color if not showing transient status, will show after
	if (!device->showingTransientStatus && !isRainbowModeExperiment(device)) {
		showColor(device, red, green, blue, false);
	}
}

void rgbShowSuccess(RGB *device) {
	showColor(device, 10, 10, 10, true);
}

void rgbShowLocked(RGB *device) {
	showColor(device, 0, 0, 20, false);
}

void rgbShowShutdown(RGB *device) {
	showColor(device, 20, 20, 20, true);
}

void rgbShowNotCharging(RGB *device) {
	showColor(device, 10, 0, 10, true);
}

void rgbShowConstantCurrentCharging(RGB *device) {
	showColor(device, 2, 0, 0, true);
}

void rgbShowConstantVoltageCharging(RGB *device) {
	showColor(device, 2, 2, 0, true);
}

void rgbShowDoneCharging(RGB *device) {
	showColor(device, 0, 2, 0, true);
}
