huntj88/MicroLights/BulbChipSTM32C071FBPx/Core/Src/microlight/i2c_log_decorate.c

/*
 * i2c_log_decorate.c
 *
 *  Created on: Jan 8, 2026
 *      Author: jameshunt
 */

#include "microlight/i2c_log_decorate.h"
#include <stddef.h>
#include <stdio.h>
#include <string.h>

// TODO: change name to log_decorate and decorate more hardware interfaces?

static void internalLog(
    Log log, const bool *enabled, const char *operation, uint8_t devAddress, uint8_t reg) {
    if (enabled && *enabled && log) {
        char buf[64];
        snprintf(
            buf,
            sizeof(buf),
            "I2C FAIL: %s addr=0x%02X reg=0x%02X\r\n",
            operation,
            devAddress,
            reg);
        log(buf, strlen(buf));
    }
}

void i2cDecoratedWrite(
    uint8_t devAddress,
    uint8_t reg,
    uint8_t value,
    I2CWriteRegisterChecked rawFunc,
    const bool *enableFlag,
    Log log) {
    if (rawFunc && !rawFunc(devAddress, reg, value)) {
        internalLog(log, enableFlag, "Write", devAddress, reg);
    }
}

bool i2cDecoratedReadRegisters(
    uint8_t devAddress,
    uint8_t startReg,
    uint8_t *buffer,
    size_t length,
    I2CReadRegisters rawFunc,
    const bool *enableFlag,
    Log log) {
    if (rawFunc && rawFunc(devAddress, startReg, buffer, length)) {
        return true;
    }
    internalLog(log, enableFlag, "ReadMul", devAddress, startReg);
    return false;
}
