huntj88/MicroLights/DevBoardAttiny3226/src/battery/BQ25180.hpp

#include <Adafruit_I2CDevice.h>
#include <Adafruit_I2CRegister.h>
#include <Arduino.h>
#include <Wire.h>

/** Default I2C address. */
#define I2CADDR_DEFAULT 0x6A
#define BQ25180_STAT0 0x00
#define BQ25180_STAT1 0x01
#define BQ25180_FLAG0 0x02
#define BQ25180_VBAT_CTRL 0x3
#define BQ25180_ICHG_CTRL 0x4
#define BQ25180_CHARGECTRL0 0x5
#define BQ25180_CHARGECTRL1 0x6
#define BQ25180_IC_CTRL 0x7
#define BQ25180_TMR_ILIM 0x8
#define BQ25180_SHIP_RST 0x9
#define BQ25180_SYS_REG 0xA
#define BQ25180_TS_CONTROL 0xB
#define BQ25180_MASK_ID 0xC

#define STAT0_DEFAULT 0b00000000       // Default value for STAT0 register (Offset = 0x0)
#define STAT1_DEFAULT 0b00000000       // Default value for STAT1 register (Offset = 0x1)
#define FLAG0_DEFAULT 0b00000000       // Default value for FLAG0 register (Offset = 0x2)
#define VBAT_CTRL_DEFAULT 0b01000110   // Default value for VBAT_CTRL register (Offset = 0x3)
#define ICHG_CTRL_DEFAULT 0b00000101   // Default value for ICHG_CTRL register (Offset = 0x4)
#define CHARGECTRL0_DEFAULT 0b00101100 // Default value for CHARGECTRL0 register (Offset = 0x5)
#define CHARGECTRL1_DEFAULT 0b01010110 // Default value for CHARGECTRL1 register (Offset = 0x6)
#define IC_CTRL_DEFAULT 0b10000100     // Default value for IC_CTRL register (Offset = 0x7)
#define TMR_ILIM_DEFAULT 0b01001101    // Default value for TMR_ILIM register (Offset = 0x8)
#define SHIP_RST_DEFAULT 0b00010001    // Default value for SHIP_RST register (Offset = 0x9)
#define SYS_REG_DEFAULT 0b01000000     // Default value for SYS_REG register (Offset = 0xA)
#define TS_CONTROL_DEFAULT 0b00000000  // Default value for TS_CONTROL register (Offset = 0xB)
#define MASK_ID_DEFAULT 0b11000000     // Default value for MASK_ID register (Offset = 0xC)

class BQ25180
{
public: /*  */
    BQ25180();
    bool begin(TwoWire *theWire = &Wire);

    bool write(uint16_t reg_addr, uint8_t flags);

    void dumpInfo();

private:
    Adafruit_I2CDevice *i2c = NULL;
};
