huntj88/MicroLights/DevBoardAttiny3226/src/mcuRegisterAlias.hpp

#define R_LED_reg PORTB
#define G_LED_reg PORTB
#define B_LED_reg PORTA

#define R_LED_bm (1 << 4)
#define G_LED_bm (1 << 5)
#define B_LED_bm (1 << 7)
