huntj88/MicroLights/BulbChipSTM32C071FBPx/Tests/test_storage.c

#include <errno.h>
#include <stdbool.h>
#include <stdint.h>
#include <stdio.h>
#include <string.h>
#include <sys/mman.h>
#include "unity.h"

// Include the mock headers
#include "mock_gpio_moder.h"
#include "stm32c0xx.h"
#include "stm32c0xx_hal.h"

// Define the FLASH global
FLASH_TypeDef mockFlashPeripheral;
FLASH_TypeDef *FLASH = &mockFlashPeripheral;

// New HAL Mocks/Stubs needed for mcu_dependencies.c
GPIO_TypeDef mockGPIOA;
TIM_TypeDef mockTIM1;
TIM_TypeDef mockTIM3;
RCC_TypeDef mockRCC = {.CR = RCC_CR_HSIUSB48RDY};
CRS_TypeDef mockCRS;
I2C_HandleTypeDef hi2c1;
RTC_HandleTypeDef hrtc;
TIM_HandleTypeDef htim1;
TIM_HandleTypeDef htim2;
TIM_HandleTypeDef htim3;
TIM_HandleTypeDef htim17;
PWR_TypeDef mockPWR;
uint16_t mockLastExtiClearedLine;

HAL_StatusTypeDef HAL_I2C_Mem_Read(
    I2C_HandleTypeDef *hi2c,
    uint16_t DevAddress,
    uint16_t MemAddress,
    uint16_t MemAddSize,
    uint8_t *pData,
    uint16_t Size,
    uint32_t Timeout) {
    return HAL_OK;
}
HAL_StatusTypeDef HAL_I2C_Mem_Write(
    I2C_HandleTypeDef *hi2c,
    uint16_t DevAddress,
    uint16_t MemAddress,
    uint16_t MemAddSize,
    uint8_t *pData,
    uint16_t Size,
    uint32_t Timeout) {
    return HAL_OK;
}
GPIO_PinState HAL_GPIO_ReadPin(GPIO_TypeDef *GPIOx, uint16_t GPIO_Pin) {
    return GPIO_PIN_RESET;
}
void HAL_GPIO_Init(GPIO_TypeDef *GPIOx, GPIO_InitTypeDef *GPIO_Init) {
    mock_simulateModerUpdate(GPIOx, GPIO_Init);
}
void HAL_GPIO_WritePin(GPIO_TypeDef *GPIOx, uint16_t GPIO_Pin, GPIO_PinState PinState) {
}
HAL_StatusTypeDef HAL_TIM_PWM_Start(TIM_HandleTypeDef *htim, uint32_t Channel) {
    return HAL_OK;
}
HAL_StatusTypeDef HAL_TIM_PWM_Stop(TIM_HandleTypeDef *htim, uint32_t Channel) {
    return HAL_OK;
}
HAL_StatusTypeDef HAL_TIM_Base_Start_IT(TIM_HandleTypeDef *htim) {
    return HAL_OK;
}
HAL_StatusTypeDef HAL_TIM_Base_Stop_IT(TIM_HandleTypeDef *htim) {
    return HAL_OK;
}
void HAL_RCC_GetClockConfig(RCC_ClkInitTypeDef *RCC_ClkInitStruct, uint32_t *pFLatency) {
}
uint32_t HAL_RCC_GetPCLK1Freq(void) {
    return 1000000;
}
HAL_StatusTypeDef HAL_I2C_Init(I2C_HandleTypeDef *hi2c) {
    return HAL_OK;
}
HAL_StatusTypeDef HAL_RTC_GetTime(
    RTC_HandleTypeDef *hrtc, RTC_TimeTypeDef *sTime, uint32_t Format) {
    (void)hrtc;
    (void)Format;
    memset(sTime, 0, sizeof(*sTime));
    return HAL_OK;
}
HAL_StatusTypeDef HAL_RTC_GetDate(
    const RTC_HandleTypeDef *hrtc, RTC_DateTypeDef *sDate, uint32_t Format) {
    (void)hrtc;
    (void)Format;
    memset(sDate, 0, sizeof(*sDate));
    sDate->Date = 1;
    sDate->Month = 1;
    sDate->WeekDay = 1;
    return HAL_OK;
}
HAL_StatusTypeDef HAL_RTC_SetAlarm_IT(
    RTC_HandleTypeDef *hrtc, RTC_AlarmTypeDef *sAlarm, uint32_t Format) {
    (void)hrtc;
    (void)sAlarm;
    (void)Format;
    return HAL_OK;
}
HAL_StatusTypeDef HAL_RTC_DeactivateAlarm(RTC_HandleTypeDef *hrtc, uint32_t Alarm) {
    (void)hrtc;
    (void)Alarm;
    return HAL_OK;
}
void HAL_PWR_EnableWakeUpPin(uint32_t WakeUpPinPolarity) {
    (void)WakeUpPinPolarity;
}
void HAL_PWR_DisableWakeUpPin(uint32_t WakeUpPinx) {
    (void)WakeUpPinx;
}
HAL_StatusTypeDef HAL_PWREx_EnableGPIOPullUp(uint32_t GPIO, uint32_t GPIONumber) {
    (void)GPIO;
    (void)GPIONumber;
    return HAL_OK;
}
HAL_StatusTypeDef HAL_PWREx_DisableGPIOPullUp(uint32_t GPIO, uint32_t GPIONumber) {
    (void)GPIO;
    (void)GPIONumber;
    return HAL_OK;
}
HAL_StatusTypeDef HAL_PWREx_DisableGPIOPullDown(uint32_t GPIO, uint32_t GPIONumber) {
    (void)GPIO;
    (void)GPIONumber;
    return HAL_OK;
}
void HAL_PWREx_EnablePullUpPullDownConfig(void) {
}
void HAL_PWREx_DisablePullUpPullDownConfig(void) {
}
void HAL_PWR_EnterSTOPMode(uint32_t Regulator, uint8_t STOPEntry) {
    (void)Regulator;
    (void)STOPEntry;
}
void HAL_PWR_EnterSTANDBYMode(void) {
}
void SystemClock_Config(void) {
}
void Error_Handler(void) {
}

// TinyUSB stubs
bool tud_connect(void) {
    return true;
}
bool tud_disconnect(void) {
    return true;
}
bool tud_connected(void) {
    return false;
}

// Mock implementations
HAL_StatusTypeDef HAL_FLASH_Unlock(void) {
    return HAL_OK;
}

HAL_StatusTypeDef FLASH_WaitForLastOperation(uint32_t Timeout) {
    return HAL_OK;
}

void FLASH_PageErase(uint32_t Page) {
    // In real hardware, this erases the page (sets to 0xFF)
    // We need to calculate the address from the page number.
    // We need to know the address of that page to erase it in our mmap-ed memory.
    // storage.h: #define FLASH_INIT 0x08000000
    // #define PAGE_SECTOR 2048

    uint32_t addr = 0x08000000 + (Page * 2048);
    memset((void *)(uintptr_t)addr, 0xFF, 2048);
}

HAL_StatusTypeDef HAL_FLASH_Lock(void) {
    return HAL_OK;
}

HAL_StatusTypeDef HAL_FLASH_Program(uint32_t TypeProgram, uint32_t Address, uint64_t Data) {
    // Write the data to the address
    *(uint64_t *)(uintptr_t)Address = Data;
    return HAL_OK;
}

void __HAL_FLASH_CLEAR_FLAG(uint32_t flags) {
    // Do nothing
}

// Include the source file under test
#include "../Core/Src/flash_string.c"
#include "../Core/Src/mcu_dependencies.c"

void setUp(void) {
    // Allocate memory at 0x08000000 to simulate Flash
    // We need enough for at least up to BULB_PAGE_0 + some modes.
    // BULB_PAGE_0 is 57. Let's allocate 1MB (512 pages).
    // 0x08000000 is the start.

    void *addr = (void *)(uintptr_t)0x08000000;
    size_t len = 1024 * 1024;  // 1MB

    // Use MAP_FIXED_NOREPLACE to force the address without overwriting.
    // Use MAP_ANONYMOUS | MAP_PRIVATE for memory.

    void *ptr = mmap(
        addr,
        len,
        PROT_READ | PROT_WRITE,
        MAP_FIXED_NOREPLACE | MAP_PRIVATE | MAP_ANONYMOUS,
        -1,
        0);

    if (ptr == MAP_FAILED) {
        printf("mmap failed: %s\n", strerror(errno));
        TEST_FAIL_MESSAGE("Failed to mmap flash memory simulation");
    }

    // Initialize to 0xFF (erased state)
    memset(ptr, 0xFF, len);

    mockGPIOA.MODER = (0x1U << (8U * 2U));  // PA8 in GPIO output mode
}

void tearDown(void) {
    // munmap
    munmap((void *)(uintptr_t)0x08000000, 1024 * 1024);
}

void test_writeSettingsToFlash_WritesDataCorrectly(void) {
    const char *testData = "TestSettings";
    writeSettingsToFlash(testData, strlen(testData));

    char readBuf[32];
    readSettingsFromFlash(readBuf, sizeof(readBuf));

    TEST_ASSERT_EQUAL_STRING(testData, readBuf);
}

void test_writeSettingsToFlash_TruncatesIfTooLong(void) {
    // Create a buffer larger than PAGE_SECTOR
    char largeBuf[PAGE_SECTOR + 100];
    memset(largeBuf, 'A', sizeof(largeBuf));
    largeBuf[sizeof(largeBuf) - 1] = '\0';

    writeSettingsToFlash(largeBuf, strlen(largeBuf));

    char readBuf[PAGE_SECTOR + 100];
    readSettingsFromFlash(readBuf, PAGE_SECTOR);  // Read up to page sector

    // The stored string should be truncated to PAGE_SECTOR - 1
    // And null terminated.

    size_t len = strlen(readBuf);
    TEST_ASSERT_EQUAL_UINT32(PAGE_SECTOR - 1, len);
    TEST_ASSERT_EQUAL_CHAR('A', readBuf[0]);
    TEST_ASSERT_EQUAL_CHAR('A', readBuf[PAGE_SECTOR - 2]);
    TEST_ASSERT_EQUAL_CHAR('\0', readBuf[PAGE_SECTOR - 1]);
}

void test_writeBulbModeToFlash_WritesDataCorrectly(void) {
    const char *testData = "ModeData";
    uint8_t mode = 1;
    writeModeToFlash(mode, testData, strlen(testData));

    char readBuf[32];
    readModeFromFlash(mode, readBuf, sizeof(readBuf));

    TEST_ASSERT_EQUAL_STRING(testData, readBuf);
}

void test_readSettingsFromFlash_ReturnsEmptyString_WhenFlashIsErased(void) {
    // Flash is initialized to 0xFF in setUp
    // But writeSettingsToFlash hasn't been called.
    // readSettingsFromFlash should handle 0xFF.

    char readBuf[32];
    readSettingsFromFlash(readBuf, sizeof(readBuf));

    TEST_ASSERT_EQUAL_STRING("", readBuf);
}

int main(void) {
    UNITY_BEGIN();
    RUN_TEST(test_readSettingsFromFlash_ReturnsEmptyString_WhenFlashIsErased);
    RUN_TEST(test_writeBulbModeToFlash_WritesDataCorrectly);
    RUN_TEST(test_writeSettingsToFlash_TruncatesIfTooLong);
    RUN_TEST(test_writeSettingsToFlash_WritesDataCorrectly);
    return UNITY_END();
}
