huntj88/MicroLights/BulbChipSTM32C071FBPx/Tests/microlight/test_settings_manager.c

#include <stdbool.h>
#include <stdint.h>
#include <stdio.h>
#include <string.h>
#include "lwjson/lwjson.h"
#include "microlight/chip_state.h"
#include "microlight/device/bq25180.h"
#include "microlight/device/button.h"
#include "microlight/device/mc3479.h"
#include "microlight/device/rgb_led.h"
#include "microlight/json/json_buf.h"
#include "microlight/mode_manager.h"
#include "microlight/model/cli_model.h"
#include "microlight/settings_manager.h"
#include "unity.h"
// Mock Data
static ModeManager mockModeManager;
static Button mockButton;
static BQ25180 mockCharger;
static MC3479 mockAccel;
static RGBLed mockCaseLed;
static RGBLed mockFrontLed;
static ChipState state;
static char lastSerialOutput[100];
#define TEST_JSON_BUFFER_SIZE 2048
char testJsonBuf[TEST_JSON_BUFFER_SIZE];

// Mocks for settings_manager.c
CliInput cliInput;
bool parseJsonCalled = false;
void parseJson(const char buf[], size_t count, CliInput *input) {
    parseJsonCalled = true;
    // Check if buf contains "modeCount" which implies valid settings in our mock
    if (strstr(buf, "modeCount") != NULL) {
        input->parsedType = parseWriteSettings;
    } else {
        input->parsedType = parseError;
    }
}

void mock_readSavedSettings(char buffer[], size_t length) {
    // Simulate empty flash
    memset(buffer, 0, length);
}

// Mocks for chip_state.c
uint32_t mock_convertTicksToMs(uint32_t ticks) {
    return ticks * 10;
}

void mock_writeUsbSerial(const char *buf, size_t count) {
    strncpy(lastSerialOutput, buf, count);
    lastSerialOutput[count] = '\0';
}

void mock_enableChipTickTimer(bool enable) {
}

void mock_enableCaseLedTimer(bool enable) {
}

void mock_enableFrontLedTimer(bool enable) {
}

void mock_enableAutoOffTimer(bool enable) {
}

void mock_enableUsbClock(bool enable) {
}

enum ChargeState getChargingState(BQ25180 *dev, uint32_t milliseconds) {
    (void)milliseconds;
    return notConnected;
}
void loadMode(ModeManager *manager, uint8_t index) {
}
enum ButtonResult buttonInputTask(Button *button, uint32_t ms, bool interruptTriggered) {
    return ignore;
}
void rgbShowSuccess(RGBLed *led) {
}
void rgbShowLocked(RGBLed *led) {
}
void rgbShowShutdown(RGBLed *led) {
}
void rgbSetWhiteBalance(RGBLed *device, RGBWhiteBalance whiteBalance) {
}
void lock(BQ25180 *dev) {
}
void disableWatchdog(BQ25180 *dev) {
}
void rgbTransientTask(RGBLed *led, uint32_t ms) {
}
void mc3479Task(MC3479 *dev, uint32_t ms) {
}
void mc3479Disable(MC3479 *dev) {
}
void chargerTask(BQ25180 *dev, uint32_t ms, ChargerTaskFlags flags) {
}
ModeOutputs modeTask(
    ModeManager *manager,
    uint32_t ms,
    bool canUpdateFrontLed,
    bool canUpdateCaseLed,
    uint8_t equationEvalIntervalMs) {
    (void)manager;
    (void)ms;
    (void)canUpdateFrontLed;
    (void)canUpdateCaseLed;
    (void)equationEvalIntervalMs;
    return (ModeOutputs){
        .frontValid = false,
        .caseValid = false,
        .frontType = BULB,
    };
}
bool isFakeOff(ModeManager *manager) {
    return false;
}
bool isEvaluatingButtonPress(Button *button) {
    return false;
}
void fakeOffMode(ModeManager *manager) {
}
void enterStandbyMode(void) {
}
void enterStopModeWithRtcAlarm(uint16_t wakeIntervalSeconds) {
    (void)wakeIntervalSeconds;
}
bool mock_waitForButtonWakeOrAutoLock(uint16_t lockThresholdMinutes) {
    (void)lockThresholdMinutes;
    return false;
}
void mock_systemReset(void) {
}

// Include source files under test
#include "../../Core/Src/microlight/chip_state.c"
#include "../../Core/Src/microlight/model/mode_state.c"
#include "../../Core/Src/microlight/settings_manager.c"

void setUp(void) {
    memset(&mockModeManager, 0, sizeof(ModeManager));
    memset(&mockButton, 0, sizeof(Button));
    memset(&mockCharger, 0, sizeof(BQ25180));
    memset(&mockAccel, 0, sizeof(MC3479));
    memset(&mockCaseLed, 0, sizeof(RGBLed));
    memset(&mockFrontLed, 0, sizeof(RGBLed));
    state = (ChipState){0};
    initSharedJsonIOBuffer(testJsonBuf, TEST_JSON_BUFFER_SIZE);
}

void tearDown(void) {
}

void test_UpdateSettings_UpdatesChipStateSettings(void) {
    // 1. Setup SettingsManager
    SettingsManager settingsManager;
    memset(&settingsManager, 0, sizeof(SettingsManager));

    // Initialize currentSettings manually
    settingsManager.currentSettings.modeCount = 5;
    settingsManager.currentSettings.minutesUntilAutoOff = 10;

    // 2. Configure ChipState with pointer to settingsManager.currentSettings
    configureChipState(
        &state,
        (ChipDependencies){
            .modeManager = &mockModeManager,
            .settings = &settingsManager.currentSettings,
            .button = &mockButton,
            .chargerIC = &mockCharger,
            .accel = &mockAccel,
            .caseLed = &mockCaseLed,
            .frontLed = &mockFrontLed,
            .enableChipTickTimer = mock_enableChipTickTimer,
            .enableCaseLedTimer = mock_enableCaseLedTimer,
            .enableFrontLedTimer = mock_enableFrontLedTimer,
            .enableAutoOffTimer = mock_enableAutoOffTimer,
            .enableUsbClock = mock_enableUsbClock,
            .enterStandbyMode = enterStandbyMode,
            .waitForButtonWakeOrAutoLock = mock_waitForButtonWakeOrAutoLock,
            .systemReset = mock_systemReset,
            .log = mock_writeUsbSerial,
        });

    // 3. Verify initial state
    TEST_ASSERT_EQUAL_UINT8(5, state.deps.settings->modeCount);

    // 4. Create new settings
    ChipSettings newSettings;
    memset(&newSettings, 0, sizeof(ChipSettings));
    newSettings.modeCount = 10;
    newSettings.minutesUntilAutoOff = 20;
    newSettings.minutesUntilLockAfterAutoOff = 5;
    newSettings.equationEvalIntervalMs = 50;
    newSettings.shutdownPolicy = autoOffNoAutoLock;
    newSettings.frontWhiteBalanceRed = 255;
    newSettings.frontWhiteBalanceGreen = 200;
    newSettings.frontWhiteBalanceBlue = 160;
    newSettings.caseWhiteBalanceRed = 195;
    newSettings.caseWhiteBalanceGreen = 255;
    newSettings.caseWhiteBalanceBlue = 255;

    // 5. Call updateSettings
    updateSettings(&settingsManager, &newSettings);

    // 6. Verify ChipState sees the change
    TEST_ASSERT_EQUAL_UINT8(10, state.deps.settings->modeCount);
    TEST_ASSERT_EQUAL_UINT16(20, state.deps.settings->minutesUntilAutoOff);
    TEST_ASSERT_EQUAL_UINT8(50, state.deps.settings->equationEvalIntervalMs);
    TEST_ASSERT_EQUAL_UINT8(autoOffNoAutoLock, state.deps.settings->shutdownPolicy);
    TEST_ASSERT_EQUAL_UINT8(255, state.deps.settings->frontWhiteBalanceRed);
    TEST_ASSERT_EQUAL_UINT8(200, state.deps.settings->frontWhiteBalanceGreen);
    TEST_ASSERT_EQUAL_UINT8(160, state.deps.settings->frontWhiteBalanceBlue);
    TEST_ASSERT_EQUAL_UINT8(195, state.deps.settings->caseWhiteBalanceRed);
    TEST_ASSERT_EQUAL_UINT8(255, state.deps.settings->caseWhiteBalanceGreen);
    TEST_ASSERT_EQUAL_UINT8(255, state.deps.settings->caseWhiteBalanceBlue);
}

void test_SettingsManagerInit_SetsDefaults(void) {
    SettingsManager settingsManager;
    memset(&settingsManager, 0, sizeof(SettingsManager));

    // Reset mock state
    parseJsonCalled = false;
    cliInput.parsedType = parseError;  // Ensure parseJson doesn't trigger updateSettings

    settingsManagerInit(&settingsManager, mock_readSavedSettings);

    TEST_ASSERT_EQUAL_UINT8(0, settingsManager.currentSettings.modeCount);
    TEST_ASSERT_EQUAL_UINT8(90, settingsManager.currentSettings.minutesUntilAutoOff);
    TEST_ASSERT_EQUAL_UINT8(10, settingsManager.currentSettings.minutesUntilLockAfterAutoOff);
    TEST_ASSERT_EQUAL_UINT8(20, settingsManager.currentSettings.equationEvalIntervalMs);
    TEST_ASSERT_EQUAL_UINT8(
        DEFAULT_SHUTDOWN_POLICY, settingsManager.currentSettings.shutdownPolicy);
    TEST_ASSERT_EQUAL_UINT8(255, settingsManager.currentSettings.frontWhiteBalanceRed);
    TEST_ASSERT_EQUAL_UINT8(110, settingsManager.currentSettings.frontWhiteBalanceGreen);
    TEST_ASSERT_EQUAL_UINT8(60, settingsManager.currentSettings.frontWhiteBalanceBlue);
    TEST_ASSERT_EQUAL_UINT8(140, settingsManager.currentSettings.caseWhiteBalanceRed);
    TEST_ASSERT_EQUAL_UINT8(210, settingsManager.currentSettings.caseWhiteBalanceGreen);
    TEST_ASSERT_EQUAL_UINT8(255, settingsManager.currentSettings.caseWhiteBalanceBlue);
}

void mock_readSavedSettings_Matching(char buffer[], size_t length) {
    snprintf(buffer, length, "{\"modeCount\":0,\"equationEvalIntervalMs\":20}");
}

void test_SettingsManagerInit_DoesNotWriteFlash_WhenFlashMatches(void) {
    SettingsManager settingsManager;
    memset(&settingsManager, 0, sizeof(SettingsManager));

    // Reset mock state
    parseJsonCalled = false;
    cliInput.parsedType = parseError;

    settingsManagerInit(&settingsManager, mock_readSavedSettings_Matching);
}

void mock_readSavedSettings_OldVersion(char buffer[], size_t length) {
    snprintf(buffer, length, "{\"modeCount\":5}");
}

void test_SettingsManagerInit_MergesDefaults_WhenNewFieldMissing(void) {
    SettingsManager settingsManager;
    memset(&settingsManager, 0, sizeof(SettingsManager));

    // Reset mock state
    parseJsonCalled = false;

    // Simulate successful parse of the OLD version
    // The parser would see "modeCount":5, but miss "equationEvalIntervalMs".
    // So it would produce a struct with modeCount=5 and equationEvalIntervalMs=DEFAULT(20).
    cliInput.parsedType = parseWriteSettings;
    cliInput.settings.modeCount = 5;
    cliInput.settings.equationEvalIntervalMs = 20;  // Default
    cliInput.settings.shutdownPolicy = autoOffAndAutoLock;

    settingsManagerInit(&settingsManager, mock_readSavedSettings_OldVersion);

    // Verify loaded settings are correct (merged)
    TEST_ASSERT_EQUAL_UINT8(5, settingsManager.currentSettings.modeCount);
    TEST_ASSERT_EQUAL_UINT8(20, settingsManager.currentSettings.equationEvalIntervalMs);
}

void test_SettingsJson_KeysMatchMacroCount(void) {
    char buf[TEST_JSON_BUFFER_SIZE];

    // getSettingsDefaultsJson returns a valid JSON object: {...}
    getSettingsDefaultsJson(buf, sizeof(buf));

    // Parse JSON
    lwjson_token_t tokens[128];
    lwjson_t lwjson;
    lwjson_init(&lwjson, tokens, LWJSON_ARRAYSIZE(tokens));
    TEST_ASSERT_EQUAL(lwjsonOK, lwjson_parse(&lwjson, buf));

    // The root token is the object itself
    TEST_ASSERT_EQUAL(LWJSON_TYPE_OBJECT, lwjson.first_token.type);

    // Count keys in root object
    int keyCount = 0;
    for (const lwjson_token_t *child = lwjson.first_token.u.first_child; child != NULL;
         child = child->next) {
        keyCount++;
    }

    int macroCount = 0;
#define X_COUNT(type, name, def) macroCount++;
    CHIP_SETTINGS_MAP(X_COUNT)
#undef X_COUNT

    TEST_ASSERT_EQUAL_MESSAGE(macroCount, keyCount, "JSON key count mismatch");

    lwjson_free(&lwjson);
}

void test_SettingsMetadataJson_ContainsShutdownPolicyOptions(void) {
    char buf[SETTINGS_METADATA_JSON_SIZE];

    getSettingsMetadataJson(buf, sizeof(buf));

    lwjson_token_t tokens[128];
    lwjson_t lwjson;
    lwjson_init(&lwjson, tokens, LWJSON_ARRAYSIZE(tokens));
    TEST_ASSERT_EQUAL(lwjsonOK, lwjson_parse(&lwjson, buf));

    const lwjson_token_t *shutdownPolicyToken = lwjson_find(&lwjson, "shutdownPolicy");
    TEST_ASSERT_NOT_NULL(shutdownPolicyToken);

    const lwjson_token_t *typeToken = lwjson_find(&lwjson, "shutdownPolicy.type");
    TEST_ASSERT_NOT_NULL(typeToken);
    TEST_ASSERT_EQUAL(LWJSON_TYPE_STRING, typeToken->type);
    TEST_ASSERT_EQUAL_size_t(strlen("enum"), typeToken->u.str.token_value_len);
    TEST_ASSERT_EQUAL_STRING_LEN(
        "enum", typeToken->u.str.token_value, typeToken->u.str.token_value_len);

    const lwjson_token_t *optionsToken = lwjson_find(&lwjson, "shutdownPolicy.options");
    TEST_ASSERT_NOT_NULL(optionsToken);
    TEST_ASSERT_EQUAL(LWJSON_TYPE_OBJECT, optionsToken->type);

    int optionCount = 0;
    for (const lwjson_token_t *child = optionsToken->u.first_child; child != NULL;
         child = child->next) {
        optionCount++;
    }

    int macroCount = 0;
#define X_COUNT(name, value, label) macroCount++;
    SHUTDOWN_POLICY_MAP(X_COUNT)
#undef X_COUNT

    TEST_ASSERT_EQUAL(macroCount, optionCount);

    const lwjson_token_t *autoOffToken =
        lwjson_find(&lwjson, "shutdownPolicy.options.autoOffNoAutoLock");
    TEST_ASSERT_NOT_NULL(autoOffToken);
    TEST_ASSERT_EQUAL(LWJSON_TYPE_NUM_INT, autoOffToken->type);
    TEST_ASSERT_EQUAL_INT(autoOffNoAutoLock, autoOffToken->u.num_int);

    lwjson_free(&lwjson);
}

void test_generateSettingsResponse_WithSettings(void) {
    SettingsManager settingsManager;
    memset(&settingsManager, 0, sizeof(SettingsManager));
    settingsManagerInit(&settingsManager, mock_readSavedSettings_Matching);

    char buffer[1024];
    // Mock flash read will populate this inside getSettingsResponse
    // But wait, getSettingsResponse calls loadSettingsFromFlash which calls readSavedSettings.
    // mock_readSavedSettings_Matching writes "{\"modeCount\":0,\"equationEvalIntervalMs\":20}"

    getSettingsResponse(&settingsManager, buffer, sizeof(buffer));

    // 1. Verify full string content
    char defaultsBuf[SETTINGS_DEFAULTS_JSON_SIZE];
    getSettingsDefaultsJson(defaultsBuf, sizeof(defaultsBuf));
    char metadataBuf[SETTINGS_METADATA_JSON_SIZE];
    getSettingsMetadataJson(metadataBuf, sizeof(metadataBuf));

    char expected[1024];
    // The mock writes valid settings, so we expect them in the output
    sprintf(
        expected,
        "{\"settings\":{\"modeCount\":0,\"equationEvalIntervalMs\":20},\"defaults\":%s,"
        "\"metadata\":%s}\n",
        defaultsBuf,
        metadataBuf);

    TEST_ASSERT_EQUAL_STRING(expected, buffer);

    // 2. Verify it is valid JSON
    lwjson_token_t tokens[128];
    lwjson_t lwjson;
    lwjson_init(&lwjson, tokens, LWJSON_ARRAYSIZE(tokens));

    // Remove newline for parser if necessary, but lwjson might handle it.
    // Let's try parsing as is.
    TEST_ASSERT_EQUAL(lwjsonOK, lwjson_parse(&lwjson, buffer));

    const lwjson_token_t *t = lwjson_find(&lwjson, "settings");
    TEST_ASSERT_NOT_NULL(t);

    t = lwjson_find(&lwjson, "defaults");
    TEST_ASSERT_NOT_NULL(t);

    t = lwjson_find(&lwjson, "metadata");
    TEST_ASSERT_NOT_NULL(t);

    lwjson_free(&lwjson);
}

void test_generateSettingsResponse_NullSettings(void) {
    SettingsManager settingsManager;
    memset(&settingsManager, 0, sizeof(SettingsManager));
    settingsManagerInit(&settingsManager, mock_readSavedSettings);  // Writes 0s (empty)

    char buffer[1024];

    getSettingsResponse(&settingsManager, buffer, sizeof(buffer));

    // 1. Verify full string content
    char defaultsBuf[SETTINGS_DEFAULTS_JSON_SIZE];
    getSettingsDefaultsJson(defaultsBuf, sizeof(defaultsBuf));
    char metadataBuf[SETTINGS_METADATA_JSON_SIZE];
    getSettingsMetadataJson(metadataBuf, sizeof(metadataBuf));

    char expected[1024];
    sprintf(
        expected,
        "{\"settings\":null,\"defaults\":%s,\"metadata\":%s}\n",
        defaultsBuf,
        metadataBuf);

    TEST_ASSERT_EQUAL_STRING(expected, buffer);

    // 2. Verify it is valid JSON
    lwjson_token_t tokens[128];
    lwjson_t lwjson;
    lwjson_init(&lwjson, tokens, LWJSON_ARRAYSIZE(tokens));

    TEST_ASSERT_EQUAL(lwjsonOK, lwjson_parse(&lwjson, buffer));

    const lwjson_token_t *t = lwjson_find(&lwjson, "settings");
    TEST_ASSERT_NOT_NULL(t);
    TEST_ASSERT_EQUAL(LWJSON_TYPE_NULL, t->type);

    t = lwjson_find(&lwjson, "defaults");
    TEST_ASSERT_NOT_NULL(t);

    t = lwjson_find(&lwjson, "metadata");
    TEST_ASSERT_NOT_NULL(t);

    lwjson_free(&lwjson);
}

void test_SettingsDefaultsJson_FitsInBufferSize(void) {
    char buffer[SETTINGS_DEFAULTS_JSON_SIZE];
    int len = getSettingsDefaultsJson(buffer, sizeof(buffer));

    // len is the number of characters that would have been written if n had been sufficiently
    // large, not counting the terminating null character. So we need len < sizeof(buffer) for it to
    // fit with null terminator.
    TEST_ASSERT_LESS_THAN_INT_MESSAGE(
        SETTINGS_DEFAULTS_JSON_SIZE,
        len,
        "Defaults JSON too large for buffer, increase size if needed");
}

void test_SettingsMetadataJson_FitsInBufferSize(void) {
    char buffer[SETTINGS_METADATA_JSON_SIZE];
    int len = getSettingsMetadataJson(buffer, sizeof(buffer));

    TEST_ASSERT_LESS_THAN_INT_MESSAGE(
        SETTINGS_METADATA_JSON_SIZE,
        len,
        "Metadata JSON too large for buffer, increase size if needed");
}

int main(void) {
    UNITY_BEGIN();
    RUN_TEST(test_SettingsDefaultsJson_FitsInBufferSize);
    RUN_TEST(test_SettingsJson_KeysMatchMacroCount);
    RUN_TEST(test_SettingsManagerInit_DoesNotWriteFlash_WhenFlashMatches);
    RUN_TEST(test_SettingsManagerInit_MergesDefaults_WhenNewFieldMissing);
    RUN_TEST(test_SettingsManagerInit_SetsDefaults);
    RUN_TEST(test_SettingsMetadataJson_ContainsShutdownPolicyOptions);
    RUN_TEST(test_SettingsMetadataJson_FitsInBufferSize);
    RUN_TEST(test_UpdateSettings_UpdatesChipStateSettings);
    RUN_TEST(test_generateSettingsResponse_NullSettings);
    RUN_TEST(test_generateSettingsResponse_WithSettings);
    return UNITY_END();
}
