huntj88/MicroLights/BulbChipSTM32C071FBPx/Tests/microlight/device/test_bq25180.c

#include <stdbool.h>
#include <string.h>
#include "lwjson/lwjson.h"
#include "microlight/device/bq25180.h"
#include "unity.h"

// Mocks
static uint8_t mockRegisters[20];
static uint8_t lastWrittenReg;
static uint8_t lastWrittenValue;
static bool writeCalled = false;
static bool mockReadRegistersShouldFail = false;
static char serialBuffer[1024];
static uint32_t serialBufferLen = 0;

bool mock_readRegisters(uint8_t devAddress, uint8_t startReg, uint8_t *buf, size_t len) {
    (void)devAddress;
    if (mockReadRegistersShouldFail) {
        return false;
    }

    if (startReg + len <= 20) {
        memcpy(buf, &mockRegisters[startReg], len);
        return true;
    }
    return false;
}

void mock_writeRegister(uint8_t devAddress, uint8_t reg, uint8_t value) {
    lastWrittenReg = reg;
    lastWrittenValue = value;
    writeCalled = true;
    mockRegisters[reg] = value;
}

void mock_writeToSerial(const char *buf, size_t count) {
    if (serialBufferLen + count <= sizeof(serialBuffer) - 1) {
        memcpy(serialBuffer + serialBufferLen, buf, count);
        serialBufferLen += count;
        serialBuffer[serialBufferLen] = '\0';
    }
}

// RGB Mocks
bool rgbNotChargingCalled = false;
bool rgbConstantCurrentCalled = false;
bool rgbConstantVoltageCalled = false;
bool rgbDoneChargingCalled = false;

void rgbShowNotCharging(RGBLed *led) {
    rgbNotChargingCalled = true;
}
void rgbShowConstantCurrentCharging(RGBLed *led) {
    rgbConstantCurrentCalled = true;
}
void rgbShowConstantVoltageCharging(RGBLed *led) {
    rgbConstantVoltageCalled = true;
}
void rgbShowDoneCharging(RGBLed *led) {
    rgbDoneChargingCalled = true;
}
void rgbShowUserColor(RGBLed *led, uint8_t r, uint8_t g, uint8_t b) {
}

// Include source under test
#include "../../../Core/Src/microlight/device/bq25180.c"

static BQ25180 charger;
static RGBLed mockLed;

void setUp(void) {
    memset(&charger, 0, sizeof(BQ25180));
    memset(&mockLed, 0, sizeof(RGBLed));

    memset(mockRegisters, 0, sizeof(mockRegisters));
    writeCalled = false;
    lastWrittenReg = 0;
    lastWrittenValue = 0;
    mockReadRegistersShouldFail = false;

    serialBufferLen = 0;
    serialBuffer[0] = '\0';

    rgbNotChargingCalled = false;
    rgbConstantCurrentCalled = false;
    rgbConstantVoltageCalled = false;
    rgbDoneChargingCalled = false;

    bq25180Init(
        &charger, mock_readRegisters, mock_writeRegister, 0x6A, mock_writeToSerial, &mockLed);

    // Reset write flag after init, as init performs writes
    writeCalled = false;
    lastWrittenReg = 0;
    lastWrittenValue = 0;
}

void tearDown(void) {
}

void test_Bq25180Init_Configures160SecondHardwareResetWatchdog(void) {
    BQ25180 freshCharger = {0};

    bq25180Init(
        &freshCharger, mock_readRegisters, mock_writeRegister, 0x6A, mock_writeToSerial, &mockLed);

    TEST_ASSERT_EQUAL_UINT8(
        BQ25180_WATCHDOG_160S_HW_RESET, mockRegisters[BQ25180_IC_CTRL] & BQ25180_WATCHDOG_SEL_MASK);
}

void test_DisableWatchdog_DisablesHostWatchdog(void) {
    disableWatchdog(&charger);

    TEST_ASSERT_TRUE(writeCalled);
    TEST_ASSERT_EQUAL_UINT8(BQ25180_IC_CTRL, lastWrittenReg);
    TEST_ASSERT_EQUAL_UINT8(
        BQ25180_WATCHDOG_DISABLED, lastWrittenValue & BQ25180_WATCHDOG_SEL_MASK);
}

void test_ChargerTask_Locks_WhenUnplugged_And_UnplugLockEnabled(void) {
    // 1. Setup initial state: Connected and Charging
    charger.chargingState = constantCurrent;

    // 2. Setup mock registers to return Not Connected
    // STAT0 register: bit 0 is 0 (not connected)
    mockRegisters[BQ25180_STAT0] = 0b00000000;

    // 3. Trigger interrupt handling

    // 4. Run task with unplugLockEnabled = true
    chargerTask(
        &charger,
        1000,
        (ChargerTaskFlags){
            .interruptTriggered = true, .unplugLockEnabled = true});  // interruptTriggered=true

    // 5. Verify lock was called (Ship Mode enabled)
    // enableShipMode writes 0b01000001 to BQ25180_SHIP_RST (0x9)
    TEST_ASSERT_TRUE(writeCalled);
    TEST_ASSERT_EQUAL_UINT8(BQ25180_SHIP_RST, lastWrittenReg);
    TEST_ASSERT_EQUAL_UINT8(0b01000001, lastWrittenValue);
}

void test_ChargerTask_DoesNotLock_WhenUnplugged_And_UnplugLockDisabled(void) {
    charger.chargingState = constantCurrent;
    mockRegisters[BQ25180_STAT0] = 0b00000000;  // Not connected

    chargerTask(
        &charger,
        1000,
        (ChargerTaskFlags){.interruptTriggered = true});  // unplugLockEnabled = false

    TEST_ASSERT_FALSE(writeCalled);
}

void test_ChargerTask_PeriodicallyShowsChargingState(void) {
    charger.chargingState = constantCurrent;
    charger.registersReadAtMs = 100;  // Prevent register read

    // Test at (ms & 0x3FF) < 50 (e.g., 1024)
    chargerTask(&charger, 1024, (ChargerTaskFlags){.chargeLedEnabled = true});  // ledEnabled = true
    TEST_ASSERT_TRUE(rgbConstantCurrentCalled);

    // Reset
    rgbConstantCurrentCalled = false;

    // Test at (ms & 0x3FF) >= 50 (e.g., 1100)
    chargerTask(&charger, 1100, (ChargerTaskFlags){.chargeLedEnabled = true});
    TEST_ASSERT_FALSE(rgbConstantCurrentCalled);
}

void test_ChargerTask_DoesNotUpdateLed_WhenChargeLedDisabled(void) {
    charger.chargingState = constantCurrent;
    charger.registersReadAtMs = 100;  // Prevent register read

    chargerTask(&charger, 1024, (ChargerTaskFlags){.chargeLedEnabled = false});

    TEST_ASSERT_FALSE(rgbConstantCurrentCalled);
}

void test_ChargerTask_UpdatesLed_WhenStateChangesFromNotConnectedToConnected(void) {
    // Initial state: Not Connected
    charger.chargingState = notConnected;
    charger.registersReadAtMs = 100;  // Prevent register read

    // New state in registers: Done charging
    mockRegisters[BQ25180_STAT0] = 0b01100000;  // Done charging (Bit 6=1, Bit 5=1)

    // Run task at time that does NOT trigger periodic flash
    chargerTask(
        &charger,
        1060,
        (ChargerTaskFlags){
            .interruptTriggered = true, .chargeLedEnabled = true});  // Interrupt triggered

    // Should update internal state
    TEST_ASSERT_EQUAL(done, charger.chargingState);

    // Should show new state
    TEST_ASSERT_TRUE(rgbDoneChargingCalled);
}

void test_ChargerTask_WritesRegistersToSerial_WhenSerialEnabled(void) {
    // Setup mock registers with known values
    mockRegisters[BQ25180_STAT0] = 0b10101010;
    mockRegisters[BQ25180_STAT1] = 0b01010101;
    // ... other registers will be 0 by default from setUp

    // Force watchdog update condition (checkedAtMs == 0)
    charger.registersReadAtMs = 0;

    // Run task with serialEnabled = true
    chargerTask(&charger, 1000, (ChargerTaskFlags){.serialEnabled = true});

    // Verify the output contains the expected binary strings
    TEST_ASSERT_NOT_NULL(strstr(serialBuffer, "\"stat0\":\"10101010\""));
    TEST_ASSERT_NOT_NULL(strstr(serialBuffer, "\"stat1\":\"01010101\""));
    TEST_ASSERT_NOT_NULL(strstr(serialBuffer, "\"flag0\":\"00000000\""));
}

void test_ChargerTask_WritesValidJson_And_FitsInBuffer(void) {
    // Force watchdog update condition (checkedAtMs == 0)
    charger.registersReadAtMs = 0;

    // Run task with serialEnabled = true
    chargerTask(&charger, 1000, (ChargerTaskFlags){.serialEnabled = true});

    // Check validity
    lwjson_t lwjson;
    lwjson_token_t tokens[128];
    lwjson_init(&lwjson, tokens, LWJSON_ARRAYSIZE(tokens));

    TEST_ASSERT_EQUAL_MESSAGE(
        lwjsonOK, lwjson_parse(&lwjson, serialBuffer), "JSON output is invalid, check buffer size");

    /* Ensure JSON output fits within the serial buffer (leaving room for null terminator) */
    TEST_ASSERT_TRUE_MESSAGE(
        serialBufferLen < sizeof(serialBuffer) - 1, "JSON output exceeds buffer size");
    /* Ensure JSON output is terminated with a newline character */
    TEST_ASSERT_TRUE_MESSAGE(
        serialBuffer[strlen(serialBuffer) - 1] == '\n', "JSON output is not newline-terminated");

    // Verify it fills the buffer exactly (minus null terminator)
    TEST_ASSERT_EQUAL_UINT32_MESSAGE(
        BQ25180_JSON_BUFFER_SIZE - 1,
        strlen(serialBuffer),
        "JSON output length mismatch with buffer size");
}

void test_GetChargingState_PreservesPreviousState_WhenReadFails(void) {
    charger.chargingState = notCharging;
    charger.chargeStateCachedAtMs = 1;
    mockReadRegistersShouldFail = true;

    enum ChargeState state = getChargingState(&charger, 2000);

    TEST_ASSERT_EQUAL(notCharging, state);
    TEST_ASSERT_EQUAL(notCharging, charger.chargingState);
}

int main(void) {
    UNITY_BEGIN();
    RUN_TEST(test_Bq25180Init_Configures160SecondHardwareResetWatchdog);
    RUN_TEST(test_ChargerTask_DoesNotLock_WhenUnplugged_And_UnplugLockDisabled);
    RUN_TEST(test_ChargerTask_DoesNotUpdateLed_WhenChargeLedDisabled);
    RUN_TEST(test_ChargerTask_Locks_WhenUnplugged_And_UnplugLockEnabled);
    RUN_TEST(test_ChargerTask_PeriodicallyShowsChargingState);
    RUN_TEST(test_ChargerTask_UpdatesLed_WhenStateChangesFromNotConnectedToConnected);
    RUN_TEST(test_ChargerTask_WritesRegistersToSerial_WhenSerialEnabled);
    RUN_TEST(test_ChargerTask_WritesValidJson_And_FitsInBuffer);
    RUN_TEST(test_DisableWatchdog_DisablesHostWatchdog);
    RUN_TEST(test_GetChargingState_PreservesPreviousState_WhenReadFails);
    return UNITY_END();
}
