huntj88/MicroLights/(commit log)

2024-06-02 3 simple modes on an attiny10 chip, barebones, no way to turn off except disconectting power
2024-06-03 flipped logic around for supplying power to led, experimenting with turning off
    [BulbChips.ino]
2024-06-19 using clock for setting high/low levels for led output
2024-06-20 using clock for led patterns and removed delays
2024-06-20 button debounce values
2024-06-21 better usage of clock, put cpu into idle mode when waiting on low LED signal from clock interrupt
2024-06-21 moved all led control for patterns into clock interrupt, delay to set led low no longer needed, added another mode
    [BulbChips.ino]
2024-06-24 added 5th mode, experimenting on wakeup from shutdown with fixing weird clock issue that can happen
    [BulbChips.ino]
2024-06-24 Added lock mode to chip tohelp prevent accidental battery drain, removed last delay
    [BulbChips.ino]
2024-06-25 Added auto off feature, clock was not running at the rate I thought it was, fixed clock rate, prescaling and clock counter to account for new system clock rate
    [BulbChips.ino]
2024-06-25 adjusted system clock speed from /64 to /32 to allow enough time for input between clock interrupts on mode 4
2024-06-25 using default system clock speed, longer sleep between interrupts, fixed a bug with button interrupt not getting enabled after lock sequence to wake up
    [BulbChips.ino]
2024-06-27 During lock sequence, don't show mode 1 when buttonDownCounter is going down after user releases too soon to enable lock
2024-06-28 added reset function, reset provided to make it easy for users to fix any rare issues the darn engineer missed.
    [BulbChips.ino]
2024-07-01 KiCad schematic of simple chip using attiny85
    [BulbChips.kicad_pcb, BulbChips.kicad_sch]
2024-07-02 changed attiny85 to QFP package
    [BulbChips.kicad_sch]
2024-07-02 adding usb connection to schematic, tx2- and tx2+ hijacked to potentially program it over usb connections using SPI protocol, before attiny has any software on it
    [BulbChips.kicad_sch]
2024-07-02 got symbol for BQ24040DSQR charger added, still need to make changes to be BQ24045DSQR ic instead
    [BulbChips.kicad_sch]
2024-07-02 moved spi programming pins to usb SBU1 and SBU2
    [BulbChips.kicad_sch]
2024-07-19 added more components to pcb
    [BulbChips.kicad_sch]
2024-07-23 fixed electrical rules checker errors, added some footprints, updated charger symbol
    [BulbChips.kicad_sch]
2024-07-24 added footprint for battery protection IC
    [BulbChips.kicad_sch]
2024-07-24 Added better footprint for charger ic, and made sure thermal pad was connected to GND
    [BulbChips.kicad_sch]
2024-07-24 updated d+/d- resistor values, and set up low speed usb
    [BulbChips.kicad_sch]
2024-07-24 added capacitor and resistor values for battery protection circuit
    [BulbChips.kicad_sch]
2024-07-24 changed usb low speed resistor from 1.5k to 2.2k because using 5v from usb, not 3.3v
    [BulbChips.kicad_sch]
2024-07-24 added 0603 size for all resistors and capacitors, switched main led out for 2 pin socket
    [BulbChips.kicad_sch]
2024-07-25 organization and labeling
    [BulbChips.kicad_sch]
2024-07-25 smaller page size
    [BulbChips.kicad_sch]
2024-07-25 updated annotations
    [BulbChips.kicad_sch]
2024-07-25 added footprints for everything, some of which are stand-ins
    [BulbChips.kicad_pcb, BulbChips.kicad_sch]
2024-07-28 working on new pcb design, should allow for more battery options, cleaned up .gitignore
    [BatteryExperimentPCB.kicad_pcb, BatteryExperimentPCB.kicad_sch]
2024-07-28 wiring lots of stuff up
    [BatteryExperimentPCB.kicad_sch]
2024-07-28 added mostfet to battery monitor voltage divider, cleanup
    [BatteryExperimentPCB.kicad_sch]
2024-07-28 add resistors to usb cc pins, fix electrical rules checker errors
    [BatteryExperimentPCB.kicad_sch]
2024-07-28 get rid of resister for low speed usb
    [BatteryExperimentPCB.kicad_sch]
2024-07-30 add low speed resistor back
    [BatteryExperimentPCB.kicad_sch]
2024-07-30 adding values for resisters and capacitors, added more decoupling capacitors
    [BatteryExperimentPCB.kicad_sch]
2024-07-30 updating data sheet for rgb led, adding more resistor values
    [BatteryExperimentPCB.kicad_sch]
2024-07-30 changed SystemLoad label to +3.75V power label
    [BatteryExperimentPCB.kicad_sch]
2024-07-31 add PMID and PMID_GO pins to breakout
    [BatteryExperimentPCB.kicad_sch]
2024-07-31 added 12th row to breakout, cleanup
    [BatteryExperimentPCB.kicad_sch]
2024-07-31 copied and customised LED_RBGA symbol for chosen part
    [BatteryExperimentPCB.kicad_sch]
2024-07-31 added all footprints!
    [BatteryExperimentPCB.kicad_sch]
2024-07-31 actually added all footprints
    [BatteryExperimentPCB.kicad_sch]
2024-08-01 updating comment, changing pin breakout order
    [BatteryExperimentPCB.kicad_sch]
2024-08-01 experimenting with pcb design
    [BatteryExperimentPCB.kicad_pcb]
2024-08-01 more pcb work
    [BatteryExperimentPCB.kicad_pcb, BatteryExperimentPCB.kicad_sch]
2024-08-03 pcb layout attempt with components on top and bottom of a two layer pcb, no ground connections yet
    [BatteryExperimentPCB.kicad_pcb, BatteryExperimentPCB.kicad_sch]
2024-08-04 second attempt at pcb design, smaller, using ground zones now
    [BatteryExperimentPCB.kicad_pcb, BatteryExperimentPCB.kicad_sch]
2024-08-04 cleaning up connections and fixing errors in rule checker
    [BatteryExperimentPCB.kicad_pcb]
2024-08-04 fixing warning
    [BatteryExperimentPCB.kicad_pcb]
2024-08-04 moving silkscreen labels around, got rid of all errors
    [BatteryExperimentPCB.kicad_pcb]
2024-08-04 converted all tracks from 0.12mm to 0.2mm
    [BatteryExperimentPCB.kicad_pcb]
2024-08-05 shrank width to fit on breadboard properly
    [BatteryExperimentPCB.kicad_pcb]
2024-08-09 redo pcb with components on single side, imported usb rohan uses
    [BatteryExperimentPCB.kicad_pcb, BatteryExperimentPCB.kicad_sch]
2024-08-09 improve ground connections
    [BatteryExperimentPCB.kicad_pcb]
2024-08-09 connect unconnected item
    [BatteryExperimentPCB.kicad_pcb]
2024-08-09 micro adjustments
    [BatteryExperimentPCB.kicad_pcb]
2024-08-09 replaced button footprint with one from jlcpcb, moved usb c over to the right to fit button
    [BatteryExperimentPCB.kicad_pcb, BatteryExperimentPCB.kicad_sch]
2024-08-10 polishing up for jlcpcb
    [BOM-BatteryExperimentPCB.csv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]
2024-08-12 another ground link
    [BatteryExperimentPCB.kicad_pcb]
2024-08-16 added battery voltage monitoring POC
2024-08-20 changed led to one with common cathode
    [BOM-BatteryExperimentPCB.csv, BatteryExperimentPCB.kicad_pcb, BatteryExperimentPCB.kicad_sch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]
2024-08-20 update parts
    [BOM-BatteryExperimentPCB.csv]
2024-08-25 sleep between counter interrupts
2024-08-25 cleanup, represent rgb values with pwm
2024-08-25 lost a tiny fraction of led color resolution in order to let the MCU go into idle for 10x as long between pwm hi/low changes
2024-08-31 i2c basic setup with screen for experimenting
2024-08-31 set up new project and imported some of the symbols/footprints from first board
    [MicroLightDevBoardV2.kicad_pcb, MicroLightDevBoardV2.kicad_sch]
2024-08-31 working on dev board v2, design is supposed to be more flexible so i don't lock myself in with mistakes
    [MicroLightDevBoardV2.kicad_sch]
2024-08-31 added 3.3v 200milliamp max buck converter, size should be tiniest possible
2024-09-01 added symbol for accelerometer
    [MicroLightDevBoardV2.kicad_sch]
2024-09-01 added optional i2c though hole resister connectors in case I need to adjust, cleanup
    [MicroLightDevBoardV2.kicad_sch]
2024-09-02 Added accelerometer setup, should be compatible with i2c or spi
    [MicroLightDevBoardV2.kicad_sch]
2024-09-02 fixed symbols referencing old footprints and assigned footprints to rest
    [MicroLightDevBoardV2.kicad_sch]
2024-09-02 organizing on pcb
    [MicroLightDevBoardV2.kicad_pcb]
2024-09-02 organizing on pcb, acl
    [MicroLightDevBoardV2.kicad_pcb]
2024-09-02 add power lanes
    [MicroLightDevBoardV2.kicad_pcb, MicroLightDevBoardV2.kicad_sch]
2024-09-02 fix pin socket footprints
    [MicroLightDevBoardV2.kicad_pcb, MicroLightDevBoardV2.kicad_sch]
2024-09-02 fixed silkscreen warnings/errors
    [MicroLightDevBoardV2.kicad_pcb]
2024-09-03 added pin labels to silk screen
    [MicroLightDevBoardV2.kicad_pcb, MicroLightDevBoardV2.kicad_sch]
2024-09-03 added button symbol and footprint
2024-09-03 add buttons to pcb, add breadboard like expansion sockets
    [MicroLightDevBoardV2.kicad_pcb, MicroLightDevBoardV2.kicad_sch]
2024-09-03 add 1uh power inductor footprint from Wurth Elektronik
    [MicroLightDevBoardV2.kicad_pcb, MicroLightDevBoardV2.kicad_sch]
2024-09-03 added 2.2uh power inductor from wurth, updated first inductor footprint
    [MicroLightDevBoardV2.kicad_pcb, MicroLightDevBoardV2.kicad_sch]
2024-09-05 adding lcsc part numbers, and more unconnected breakouts
    [MicroLightDevBoardV2.kicad_pcb, MicroLightDevBoardV2.kicad_sch]
2024-09-05 cleaning up and adding connectors
    [MicroLightDevBoardV2.kicad_pcb, MicroLightDevBoardV2.kicad_sch]
2024-09-06 updating lcsc part numbers for jlcpcb
    [BOM-MicroLightDevBoardV2.csv, MicroLightDevBoardV2.kicad_pcb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]
2024-09-06 added linear charging ic from TI
    [MicroLightDevBoardV2.kicad_sch]
2024-09-06 added connections for new charger ic
    [MicroLightDevBoardV2.kicad_sch]
2024-09-07 organized new charger ic on pcb
    [MicroLightDevBoardV2.kicad_pcb, MicroLightDevBoardV2.kicad_sch]
2024-09-07 integrated charger ic pcb breakout into the rest of the pcb
    [MicroLightDevBoardV2.kicad_pcb, MicroLightDevBoardV2.kicad_sch]
2024-09-07 added missing capacitorson charging ic pcb
    [MicroLightDevBoardV2.kicad_pcb, MicroLightDevBoardV2.kicad_sch]
2024-09-07 added capacitor values and missing resistor on TS pin of charging ic (not using TS)
    [MicroLightDevBoardV2.kicad_pcb, MicroLightDevBoardV2.kicad_sch]
2024-09-07 add lcsc part numbers
    [MicroLightDevBoardV2.kicad_pcb, MicroLightDevBoardV2.kicad_sch]
2024-09-07 exported lcsc ids to schematic symbols
    [MicroLightDevBoardV2.kicad_sch]
2024-09-07 changed inductor so jlcpcb doesn't try to autofill some random one
    [BOM-MicroLightDevBoardV2.csv, MicroLightDevBoardV2.kicad_pcb, MicroLightDevBoardV2.kicad_sch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]
2024-09-07 updated led resistor values for 3.3v
    [BOM-MicroLightDevBoardV2.csv, MicroLightDevBoardV2.kicad_pcb, MicroLightDevBoardV2.kicad_sch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]
2024-09-07 adjusted wire
    [MicroLightDevBoardV2.kicad_pcb]
2024-09-07 experimenting with side nav samples from React Pro Sidebar
2024-09-09 removed ground planes on i2c vref due to capacitance concerns, rightfully or not
    [MicroLightDevBoardV2.kicad_pcb]
2024-09-16 correct part numbers and generated ordering files
    [BOM-MicroLightDevBoardV2.csv, MicroLightDevBoardV2.kicad_pcb, MicroLightDevBoardV2.kicad_sch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]
2024-10-17 handled error case when wavefrom change array was empty
2024-11-12 working on new pcb with only bq25180 linear charger IC
    [BQ25180PCB.kicad_pcb, BQ25180PCB.kicad_sch]
2024-11-12 bq25180 basic pcb layout
    [BQ25180PCB.kicad_pcb, BQ25180PCB.kicad_sch]
2024-11-12 jlcpcb files
    [BOM-BQ25180PCB.csv, BQ25180PCB.kicad_pcb, BQ25180PCB.kicad_sch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]
2024-11-29 Setup basic i2c with bq25180 charger ic, added function to dump and display all i2c registers
2024-11-29 Added functions to set bits using bit masks and write them to charger ic over i2c, formatted code
2024-11-29 setting battery regulation voltage and charge current
2024-12-06 adjust oscillator calibration for my MCU, got Serial.println() working
    [main.cpp]
2024-12-06 Added external interrupt on pin PC2
2024-12-06 Configure charger, setup button press interrupt triggered from charger ic to attiny3226
2024-12-06 prevented charger i2c watchdog timer from resetting config
    [config.hpp, main.cpp]
2024-12-08 dump charger i2c info on charger interrupt, setup another interrupt pn PA2
2024-12-11 changed charge termination voltage to 4.4v, changed max current from 50 to 70 milliamps
2025-01-20 stm32 basic example of i2c using ezo hum temp/humidity sensor
2025-02-01 remove a bunch of peripheral devices from sample, setup reading i2c values of bq25180
2025-02-01 print register binary in easier to read format
2025-02-01 basics of configuring chargerIC over i2c
2025-02-01 basic pwm working for controlling led brightness
2025-02-12 group chargerIC dependencies in struct, which is initialized like other stm32 apis
2025-02-15 pwm of rgb led
2025-02-16 moved buttons to edit wrapper, added localstorage persistance, added color picker(unused)
2025-02-16 creating card to assign waveform to fingers and color to case led
2025-02-17 change to checkboxes for multi-finger selection, reordered files/folders
2025-02-17 extracted card to resuable component, multiple cards have shared state for selected/disabled finger positions
2025-02-19 started new stm32 project, set up debugging, timers for rgb case LED
2025-03-15 beginning stm32 usb communication, setup tinyusb
2025-03-15 stm32c071 debug capability in vs code
2025-06-26 getting tinyusb setup in project created from STM32CubeIDE
2025-06-27 add kved key value store and setup for STM32C0
2025-06-27 created fork of kved to create port for STM32C0 mcu's and open pr, setup to use the new port from library. Using my fork instead of main repo for now.
2025-06-29 reserved space in flash for bulb modes so it won't get deleted when flashing new firmware
    [main.c]
2025-06-29 remove kved, didn't read closely enough, cannot be used to save json strings. Oh well, it was fun supporting the STM32C0 mcus and submitting a PR
    [main.c]
2025-06-29 basic interrupt on timer2 for bulb modes
2025-06-29 load current mode and use it handle flashing patterns, cleanup
2025-06-29 set up button with pullup and enabled interrupt
2025-06-29 detect button clicks and advance to next mode
2025-07-01 consolidate some interrupt functions, add show color function, cleanup
2025-07-04 Add shutdown logic, wakeup can't seem to be on the same pin as button, will use the charger i2c interrupts to wake after shutdown. Move button to breadboard so I could tie it in with the wake up func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
    [BulbChipSTM32.ioc, bq25180.c, chip_state.c, main.c, main.h]
2025-07-04 create staus led functions
2025-07-08 create new empty project for STM32C071FBPx, as well as empty lib project for shared code
2025-07-09 adding bulb timer interrupt code back
2025-07-09 setup button interrupt
2025-07-09 fix button interrupt, fire on falling edge instead of rising, enable ship mode on chargerIC over i2c
    [BulbChipSTM32C071FBPx.ioc, bq25180.c, chip_state.c, main.c, rgb.c]
2025-07-09 move blue led pin, add wake up pin
2025-07-10 remove wakeup and move blue led back to where it was, enable usb
2025-07-10 add pin aliases, add interrupt for chargerIC status/faults, check which pin triggered interrupt
2025-07-12 charger task
2025-07-12 chargerIC interrupts for charge status change, and led indicator colors to match
2025-07-12 adjust timers for bulb modes, adjust button press timing handling
2025-07-12 fix bitwise comparison for battery charger led indicator
    [bq25180.c]
2025-07-13 serial writing from device to host over usb
2025-07-13 remove hal for chargerIC code, implement hal in main and pass in function pointers, send serial over usb, disconnect usb on mcu boot for proper reconnection, cleanup
2025-07-13 cleaning up led status code
2025-07-17 add dfu files that were accidently not included in last commit, cleanup, hardware reset function for bq25180, battery tracking mode for bq25180, disable interrupts during flash write
    [bootloader.c, bootloader.h, bq25180.c, chip_state.c, main.c]
2025-07-17 create and use gpio pin labels
2025-07-17 Created fake off mode for charging, added auto off timer that resets on user activity
    [chip_state.c]
2025-07-17 lock by default. When shutting down enter fake off mode, and turn lock after timeout. This enables quickly turnin them all back on when off for only a short time. Can still enter lock mode manually b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
    [chip_state.c]
2025-07-18 use dedicated timer for auto off, set auto off in minutes
2025-07-18 button result is now an enum, cleanup
2025-07-19 return json from chargerIC, setup reading and writing json with serial port on web app
2025-07-20 add cli for reading modes, shutting timers off to sleep better and turning them on for charging indicator, need to handle detecting button press with dedicated timer while click active, fix bug with 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
    [chip_state.c]
2025-07-20 start the timers for at least the duration of the click
2025-07-20 convert some enum ifs to switch case for exhaustive checks, fix bug with sending strings over serial, cleanup
    [chip_state.c, main.c]
2025-07-21 switch red and blue led pins
2025-07-25 enabled pullup resister on mcu, and removed pullup and pulldown resistors from new pcb in progress designs
    [MicroLightDevBoardV3.kicad_pcb, MicroLightDevBoardV3.kicad_sch]
2025-07-26 regenerate copper layers
    [MicroLightDevBoardV3.kicad_pcb]
2025-07-26 convert to kicad 9
    [MicroLightDevBoardV3.kicad_pcb, MicroLightDevBoardV3.kicad_sch]
2025-07-27 added button and integrated into pcb
    [MicroLightDevBoardV3.kicad_pcb, MicroLightDevBoardV3.kicad_sch]
2025-07-27 move bulb led pin, work on pcb
    [MicroLightDevBoardV3.kicad_pcb, MicroLightDevBoardV3.kicad_sch]
2025-07-27 route debug pins
    [MicroLightDevBoardV3.kicad_pcb]
2025-08-03 added battery terminals
    [MicroLightDevBoardV3.kicad_pcb]
2025-08-03 add edge cuts, fix overlap
    [MicroLightDevBoardV3.kicad_pcb]
2025-08-03 added debug connector and mousebites to remove it
    [MicroLightDevBoardV3.kicad_pcb, MicroLightDevBoardV3.kicad_sch]
2025-08-03 moved debug pins
    [MicroLightDevBoardV3.kicad_pcb]
2025-08-03 edge cut clearance work
    [MicroLightDevBoardV3.kicad_pcb]
2025-08-03 clean up edge cuts
    [MicroLightDevBoardV3.kicad_pcb]
2025-08-04 add jlcpcb part numbers
    [MicroLightDevBoardV3.kicad_sch]
2025-08-04 increased side of battery pad
    [MicroLightDevBoardV3.kicad_pcb]
2025-08-05 make chip slightly shorter, edge cuts
    [MicroLightDevBoardV3.kicad_pcb]
2025-08-05 remove lcsc ids, add some lcsc ids, add bulb led resistor
    [MicroLightDevBoardV3.kicad_pcb, MicroLightDevBoardV3.kicad_sch]
2025-08-05 update led resistor value
    [MicroLightDevBoardV3.kicad_pcb, MicroLightDevBoardV3.kicad_sch]
2025-08-05 moved debug port
    [MicroLightDevBoardV3.kicad_pcb]
2025-08-05 remove lcsc ids
    [MicroLightDevBoardV3.kicad_pcb]
2025-08-05 add lcsc ids
    [MicroLightDevBoardV3.kicad_pcb, MicroLightDevBoardV3.kicad_sch]
2025-08-05 added solder mask to battery solder points
    [MicroLightDevBoardV3.kicad_pcb]
2025-08-05 silk screen cleanup
    [MicroLightDevBoardV3.kicad_pcb]
2025-08-05 adjust position of rgb led
    [MicroLightDevBoardV3.kicad_pcb]
2025-08-06 adjusted debug pins to have smaller solder mask in vertical direction, changed bulb pins to both be circles and deleted 3d model, add usb 3d model
    [MicroLightDevBoardV3.kicad_pcb, MicroLightDevBoardV3.kicad_sch]
2025-08-06 added button and ufqfn 28 pin model
    [MicroLightDevBoardV3.kicad_pcb]
2025-08-06 change max battery voltage back to 4.4v
2025-08-07 change battery attachment from pad to through hole to increase durability
    [MicroLightDevBoardV3.kicad_pcb, MicroLightDevBoardV3.kicad_sch]
2025-08-07 start accelerometer integration
2025-08-07 use 4 layer pcb and add accelerometer ic
    [MicroLightDevBoardV3.kicad_pcb, MicroLightDevBoardV3.kicad_sch]
2025-08-07 ground layer cleanup
    [MicroLightDevBoardV3.kicad_pcb]
2025-08-08 6 layer pcb design
    [MicroLightDevBoardV3.kicad_pcb]
2025-08-09 add battery connector
    [MicroLightDevBoardV3.kicad_pcb, MicroLightDevBoardV3.kicad_sch]
2025-08-09 lcsc ids, adjust footprints, cleanup
    [MicroLightDevBoardV3.kicad_pcb, MicroLightDevBoardV3.kicad_sch]
2025-08-09 moved battery solder points, made polarity match connector, added silkscreen battery indicators
    [MicroLightDevBoardV3.kicad_pcb]
2025-08-09 moved inductor to top of board, kind of tall, added inductor 3d model
    [MicroLightDevBoardV3.kicad_pcb]
2025-08-09 fix inductor 3d model orientation, add bq25180 3d model
    [MicroLightDevBoardV3.kicad_pcb]
2025-08-15 experimenting with creating molds for chip casings
    [CasingMold.FCStd]
2025-08-15 progress on mold for chip area
    [CasingMold.FCStd]
2025-08-15 pad, cleanup size calculations
    [CasingMold.FCStd]
2025-08-15 cleanup size calc
    [CasingMold.FCStd]
2025-08-15 added usb and led casing holes in mold
    [CasingMold.FCStd]
2025-08-16 sizing calculations cleanup
    [CasingMold.FCStd]
2025-08-16 CasingMoldV2 different approach
    [CasingMold.FCStd, CasingMoldV2.FCStd]
2025-08-16 progress on different approach
    [CasingMoldV2.FCStd]
2025-08-16 chip insert position tabs
    [CasingMoldV2.FCStd]
2025-08-16 working on battery placement
    [CasingMoldV2.FCStd]
2025-08-16 battery insert allows lifting it out with the chip insert, has a spike on the bottom that matches insert in bottom of mold
    [CasingMoldV2.FCStd]
2025-08-16 made chip casing opening bigger
    [CasingMoldV2.FCStd]
2025-08-16 top part of mold progress
    [CasingMoldV2.FCStd]
2025-08-16 move casing designs to folder
    [CasingMold.FCStd, CasingMoldV2.FCStd]
2025-08-16 make alignment pins be full height of chip insert
    [CasingMoldV2.FCStd]
2025-08-16 fit tolerance setup
    [CasingMoldV2.FCStd]
2025-08-16 make led hole bigger
    [CasingMoldV2.FCStd]
2025-08-16 alignment pins
    [CasingMoldV2.FCStd]
2025-08-16 add air vents
    [CasingMoldV2.FCStd]
2025-08-16 spreadsheet sizing for air vents
    [CasingMoldV2.FCStd]
2025-08-16 air vent alignment, 0.5mm radius air vents
    [CasingMoldV2.FCStd]
2025-08-16 new battery hook instead of spike
    [CasingMoldV2.FCStd]
2025-08-16 hook progress
    [CasingMoldV2.FCStd]
2025-08-16 change fit tolerance to 0.8mm
    [CasingMoldV2.FCStd]
2025-08-16 move battery terminals farther apart on pcb
    [MicroLightDevBoardV3.kicad_pcb]
2025-08-17 improved battery insert
    [CasingMoldV2.FCStd]
2025-08-19 improved battery insert hook, less of a gap between chip insert and battery insert
    [CasingMoldV2.FCStd]
2025-08-20 make chip opening bigger, make battery hook slightly tighter
    [CasingMoldV2.FCStd]
2025-08-21 make battery hook have a tighter fit, add injection port, move air vents, make the chip opening slightly smaller to make the material thickness acceptable in the corner
    [CasingMoldV2.FCStd]
2025-08-21 adjust vent spacing
    [CasingMoldV2.FCStd]
2025-08-21 change battery hook on battery insert chambfer on the point back to 1mm from 0.5mm
    [CasingMoldV2.FCStd]
2025-08-23 cleanup silk screen
    [MicroLightDevBoardV3.kicad_pcb]
2025-08-23 deleted useless buttons, added ui to inform users how to use waveform editor
2025-08-23 move add mode, only show finger specific options if there is more than one mode card
2025-08-23 added accelerometer triggers
2025-08-23 update case light color label
2025-08-24 accelerometer mode previews, threshold selection improvement
2025-08-30 added color to accelerometer triggers
2025-08-30 case light colors on triggers, new color picker
2025-08-30 edit waveforms in modal by default, clean up buttons
2025-08-30 track which waveform was last open in editor
2025-08-31 close buttons instead of remove label buttons
2025-09-01 fix usb cc resistor under usb c
    [MicroLightDevBoardV3.kicad_pcb]
2025-09-05 pcb cleanup
    [MicroLightDevBoardV3.kicad_pcb]
2025-09-09 add pullup resistor on button, internal mcu pullup not enough because of charging ic pulses
    [MicroLightDevBoardV3.kicad_pcb, MicroLightDevBoardV3.kicad_sch]
2025-09-10 removed incorrect lcsc part number
    [MicroLightDevBoardV3.kicad_sch]
2025-09-17 basic accelerometer i2c driver for mc3479
2025-09-23 working on integrating accelerometer into mode
2025-09-24 read 6 bytes at once to get all accelerometer data in the same i2c call, enable/disable accelerometer based on mode, elevate sudo as part of usb flash script, cleanup
2025-09-26 parse new mode format, integrate accelerometer and color settings, cleanup, added todos
2025-09-27 refactor rgb to pass in dependencies, no direct mcu calls, fix sampling interval for accelerometer
    [chip_state.c, main.c, mc3479.c, rgb.c]
2025-09-27 init error handling for bq25180 charger and mc3479 acceleromoter
    [bq25180.c, chip_state.c, main.c, mc3479.c]
2025-09-27 add function to calculate number of milliseconds for elapsed chipTicks, inject into chip_state, add todos
2025-09-27 refactor button input to work based on milliseconds elapsed instead of tickCount
2025-09-27 cleanup, no longer need buttonResult ignore case
    [chip_state.c, main.c]
2025-09-27 converted chargerTask to use elapsed milliseconds instead of ticks
2025-09-27 convert rgbTask to use milliseconds instead of ticks
2025-09-27 convert mc3479Task to use milliseconds instead of ticks
2025-09-28 decreased period for rgb led timer
2025-12-13 cleanup UI and theming (#3)
    * cleanup UI and theming
    * code review
    * move play/pause/stop equation pattern buttons
    * theme colors for succes and warning
2025-12-14 Mode editor (#5)
    * first pass at creating mode editor
    * cleanup strings
    * aligned storage controls and styling
    * consolidting components
    * consolidating components
    * rename PatternButton to StyledButton and move
    * moving components
    * display mode validation errors
    * add validation rules
    * add tests
    * pattern previews
    * add tests
    * allow rgb and bulb patterns in front led
    * consolidate entity editing logic
    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
2025-12-15 Serial communication with micro light (#6)
    * first pass at integrating serial communiction
    * serial connect button
    * test and flash buttons for patterns and modes
    * theme for serial buttons
    * generate C json parser from zod model and validation rules
    * cleanup test
    * toasts for serial events
    * Update App/configure-app-v3/src/app/providers/serial-manager.ts
    * Update App/configure-app-v3/src/app/providers/serial-manager.ts
    * Update App/configure-app-v3/src/components/common/SerialConnectButton.tsx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
2025-12-18 Serial integration (#7)
    * fixed parser generator, added generated files to C embedded project
    * improved errors from mode parser, improve behavior of web app sending data
    * refactor tests to use localization key instead of english translation
    * lint and prettier
    * improved parser generator, added types and validate examples before generation, update stm32 project automatically
    * cleanup
    * integrated most of the new json format for features that already existed
    * get modes working on chip, send command from serial test button, keep mode patterns in sync with pattern json
    * rename rgb.c to led_rgb.c
    * testing sends live updates to chip
    * remove unused file
    * serial command buttons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
    [bq25180.c, chip_state.c, main.c, mc3479.c]
2025-12-22 Refactor firmware (#8)
    * add some todo's for refactoring
    * move charging code
    * extracting button
    * more button integration
    * store chip state in struct
    * mode manager
    * settings manager
    * hooking charger logic back up
    * move dfu out of chip state
    * remove some commented code, add lock back to autooff
    * splitting model and parsing
    * split model and parsing
    * cleanup types
    * fix bug with ignore being returned for button
    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
    [bq25180.c, button.c, chip_settings.h, chip_state.c]
2025-12-24 CI test for firmware, refactoring (#9)
    * add ci test for firmware
    * formatting
    * add file formatting
    * check formatting of firmware, rename firmware ci file
    * add linter
    * add clang-tidy, some lint changes
    * more linting
    * call updateMode from stateTask instead of interrupt, move logic to determine which pattern to use out of updateMode to resolveActiveComponents function
    * clean up command_parser
    * lint mode parser
    * disabling lint for a few cases of bugprone-easily-swappable-parameters
    * lint warnings short name
    * snake_case to camelCase
    * lint/format on app
    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
    [bootloader.c, bq25180.c, button.c, chip_settings.h, chip_state.c]
2025-12-24 Firmware cleanup, lint, additional CI checks (#10)
    * consolidate i2c read/write functions
    * update 1024 bytes to use 2048 bytes with PAGE_SECTOR, ordered dependencies by usage, cleanup
    * refactor fake off mode, remove led timer start/stop from chip state, update tests
    * refactoring timers start/stop
    * ignore lint in 2 places
    * changed board_get_unique_id param to be uid instead of id for lint
    * change name of registers param for lint
    * removed underscore prefixes from configureChipState
    * add headers to lint check
    * rename ms to milliseconds
    * undo lint change
    * remove functions from setting and mode manager, cleanup, add new test to make sure settings is update in chipState, rena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
2026-01-04 Equation pattern support in firmware (#11)
    * equation patterns first pass
    * add tinyexpr to lib includes
    * fixed types in test
    * use fork of tinyexpr to make binary size smaller, use floats instead of doubles. add tinyexpr to project file so includes can be resolved. Don't download libs if already available
    * prevent tinyexpr from pulling in double code
    * make equations be lowercase before passing to tinyexpr
    * consolidate json buffers to a shared preallocated buffer, ran into ram issues
    * format
    * loopAfterDuration
    * lint
    * lint
    * fix jsonLength uint32 return type because -1 is returned for unable to find end
    * check for non null pointers when freeing
    * lint
    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
    [bq25180.c, button.c, chip_settings.h, chip_state.c]
2026-01-05 Serial convenience (#12)
    * refactor writeToUsb definitions
    * adding setting to enable serial logging for charger ic
    * organized charger code
    * ensured settings defaults were always in json
    * ensured all defaults were in the json device response, app doesn't need to know about the settings before, uses json to render
    * working on convenience functions for serial messages. import mode and charger config modals
    * import modes and patterns from app
    * import all modes and patterns, rename to resolve conflicts
    * lint, validate generated setting json is valid with tests
    * null terminate flash reads
    * add length param to charger json output funcion, add te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
    [bq25180.c, chip_settings.h, chip_state.c, main.c, mc3479.c]
2026-01-11 Firmware Decoupling & Architecture Refactor (#13)
    * provide length of string using existing count varible
    * regenerate project using newer version of STM32CubeMX, also aligned timers in ioc with main.c
    * add tests for usb manager, clean up
    * update manufacturer and device name fields in usb description
    * filter out other devices in browser usb port selector
    * decouple storage from mode and settings specifi flash operations, cleanup
    * partial - DI for flash read/write, storage abstraction typedef
    * renaming and moving defines
    * fix tests
    * moving hardware independant application logic into microlight directory
    * fix tests
    * move DI to microlight.c, pass in mcu dependencie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
    [BulbChipSTM32C071FBPx.ioc, bootloader.c, bq25180.c, button.c, chip_settings.h, chip_state.c]
2026-01-15 Front rgb and consistent throughhole size (#14)
    * added rgb support using timer 3 pins. made rgb/bulb, debug, battery through holes the same diameter
    * move fred and fgreen resistors
    * move fblue resistor
    * both rgb and bulb are offset ~0.6 mm from their center, rather than having rgb be offset 1.25 mm with bulb centered
    * cleanup rules checker
    * update silkscreen
    * put fblue resistor on bottom of board, update silkscreens
    * adjust spacing for debug pads to usb
    * made all GND throughhole pads squared
    * rules checker fix
    * cleanup traces
    * rename fBlue to fBlueBulb as it controls power for blue in rgb led, as well as power for 2 pin bulb leds
    [MicroLightDevBoardV3.kicad_pcb, MicroLightDevBoardV3.kicad_sch]
2026-01-16 [PCB] Made dev pin area a bit smaller (#15)
    [MicroLightDevBoardV3.kicad_pcb]
2026-01-27 PCB battery connector, silkscreen, manufacturing changes / Firmware cleanup (#16)
    * datasheet misunderstood, charger ic only prevents maximum sys voltage from vin. Using default of 4.5v
    * refactor chip_state to move where state is stored. also pass milliseconds in to task instead of calculating and removed associated dependency
    * changed error handling in DI layer
    * improved labeling on kicad schematic
    * update battery connector symbols, attempting to do male connector and wire/crimp assembly
    * moved and made battery wire clip slightly smaller
    * cleanup and silk screen resizing. Also added James Hunt and v1 silkscreen labels
    * add edge cut instructions, add battery connector assembly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
    [MicroLightDevBoardV3.kicad_pcb, MicroLightDevBoardV3.kicad_sch]
2026-01-31 PCB cleanup and cost reduction (#17)
    * deleted battery pcb connector. moved button and case led closer to usb
    * cleanup wires and gnd plane, remove more connector stuff
    * redid battery connection to have wires go through holes on board
    * cleanup pcb connections
    * minor adjustments to pcb battery wire setup
    * silkscreen cleanup and use rounded rect instead of circle for throughhole pads
    * cleanup pcb wiring
    * cleanup pcb wiring
    [MicroLightDevBoardV3.kicad_pcb, MicroLightDevBoardV3.kicad_sch]
2026-02-01 Shortern pcb (#18)
    * move accelerometer and inductor
    * move case led off to side
    * shorten pcb by moving resistors, accelerometer, fRGB LED slightly
    * rotate battery terminals
    * cleanup, silkscreen
    * remove more pcb at back
    * move chargerIC down
    * silkscreen
    * silkscreen
    * made pcb smaller around usb
    * improve front led pads
    * cleanup pcb
    * commit missed file
    * add LCSC part numbers to schematic/pcb
    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
    [MicroLightDevBoardV3.kicad_pcb, MicroLightDevBoardV3.kicad_sch]
2026-02-03 fix usb, tusb_init() was removed accidentally
    [main.c]
2026-02-08 Front RGB LED support via TIM3 PWM + timer refactor + PCB optimization (#19)
    * updated timer and pins for integrating front rgb led
    * human tasks
    * human tasks
    * pcb: adjust inductor and battery terminals slightly
    * made dimensions exactly 12.5x14 millimeters
    * pcb: optimize ground and 3.3v planes by adjusting vias
    * adjust 3.3v buck position slightly
    * PCB: make corners be 45 degree angles
    * pcb: optimize ground plane
    * pcb: optimize routing a bit
    * pcb: optimize routing a bit
    * pcb: optimize routing a bit
    * pcb: optimize routing
    * pcb: edge cut cleanup, optimize routing
    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
    [MicroLightDevBoardV3.kicad_pcb]
2026-02-11 extend debug pins slightly further from usb, add production files to git
    [MicroLightDevBoardV3.kicad_pcb, bom.csv, designators.csv, positions.csv]
2026-02-24 PCB edge cuts routing and v-cut (#20)
    * edge cuts / panelization technique
    * add horizontal v-cut
    [MicroLightDevBoardV3.kicad_pcb, positions.csv]
2026-03-08 create jig to bend LEDS at right angle
    [JigBendLED.FCStd]
2026-03-11 update button pullup resistor value to value I (accidentally) actually used, it worked
    [MicroLightDevBoardV3.kicad_pcb, MicroLightDevBoardV3.kicad_sch]
2026-03-20 USB improvement (#21)
    * remove unused cdc channel
    * charger i2c read caching, disable mcu pullup on button
    * increase clock rate to 48mhz to follow usb spec better, front leds can use bulb or rgb patterns
    * Gate HSI48 oscillator based on USB connection state to save power
    HSI48 (~0.5-1mA draw) is only needed for USB, but was previously
    left running continuously. Now dynamically enabled/disabled based
    on charge state from the BQ25180 charger IC:
    - On boot, HSI48 is disabled if no USB power detected
    - When USB is plugged in (charger interrupt), HSI48 + CRS auto-trim
    are enabled
    - When USB is unplugged, HSI48 + CRS are disabled
    Implementation:
    - Add enableUsbClock(bool) to mcu_dependenc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
    [BulbChipSTM32C071FBPx.ioc, bq25180.c, chip_state.c, main.c, mcu_dependencies.c, mcu_dependencies.h]
2026-03-29 USB command buffering and clock scaling, build system improvements, LCSC ESD part number (#22)
    * add LCSC part number for esd
    * use cheap esd drop in replacement, disable usb peripherals when unplugged to save battery
    * drop main clock back down to 12mhz
    * updated project files and formatted code
    * buffer usb commands
    * raise clock rate to 48mhz while plugged in for faster usb enumeration
    * build from makefile
    * simplified tinyusb bsp folder
    * fix tests, add new tests
    * instructions to generate stm32 drivers with cubeMX if they do not exist
    * setup skip drivers if only for tests in ci
    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
    [MicroLightDevBoardV3.kicad_pcb, MicroLightDevBoardV3.kicad_sch]
2026-03-29 Web app refactor for mobile (#23)
    * mobile refactor first pass
    * minor adjustments
    * disable dfu button on iOS and Android
    * code review, cleanup
    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
2026-03-29 LED firmware improvements (#24)
    * gamma correction for USB, cleanup
    * always use 8khz for led pwm despite clock speed changing for usb
    * fix status led values for new gamma correction. Fix existing tests
    * fix issue with barely not reaching max led duty cycle
    * tests
    * asser/error behavior and led tests
    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
    [main.c, mcu_dependencies.c, mcu_dependencies.h, rgb_led.c, test_mcu_dependencies.c, test_rgb_led.c, test_storage.c]
2026-04-06 Shutdown Policy (#25)
    * first pass at adding stop/standby states to shutdown depending on context. move button from PA7 to PA4
    * fixing some behaviors, cleanup
    * fix button debouce, turn off MCU button pullup
    * disable accelerometer before low power
    * disable charger watchdog before sleep/standby, configure it do a HW reset if watchdog criteria met (easier to identify/debug)
    * add stop mode + autolock shutdown support for older pcb
    * add test cases
    * ensure bulb pin driven low when starting stop mode
    * prevent floating pin from waking up old pcb from stop
    * move button from PA7 to PA4 on pcb
    * don't wake before lock from auto off stop mode unless button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
    [MicroLightDevBoardV3.kicad_pcb, MicroLightDevBoardV3.kicad_sch]
2026-04-09 Chip casing model for 3D printing (#26)
    * 2 piece casing via 3d printing attempt
    * adjust fit/measurements, make walls thinner
    * casing adjustments
    * adjusted casing for z52h battery instead of z55h
    [casingPrint2Pieces.FCStd]
2026-04-12 Miscellaneous: App, Firmware, PCB, Casing (#27)
    * make sure rgb 255 translates to 100% duty cycle instead of 99.8%
    * add dfu command and enter dfu automatically when flashing new firmware
    * convert to pnpm
    * when entering lock mode, there is a slight delay from charger IC. call shutdown after lock i2c command so lights immediately turn off
    * moved battery GND to be further from battery positive, made PWM for front blue be under the ground plane, made debug terminals have barely more clearance from usb for peace of mind, change to shielded inductor
    * don't stop auto sync test preview for temporary validation error
    * remove play/pause/stop and preview swatch from simple patterns
    * split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
    [MicroLightDevBoardV3.kicad_pcb, MicroLightDevBoardV3.kicad_sch, casingPrint2Pieces.FCStd]
2026-04-12 improved casing by extending the snap locks, shrinking the diameter of the button indention, moving and increasing the size of top casing horizontal support
    [casingPrint2Pieces.FCStd]
2026-04-19 productions files used to make 40 chips
    [MicroLightDevBoardV3.kicad_pcb, bom.csv, positions.csv]
2026-04-20 add manufacturing PCB remark note to README.md
2026-04-22 casing: add supports to prevent lid from being depressed on the edges
    [casingPrint2Pieces.FCStd]
2026-04-28 create bulb holder solder jig to attach to PCB
    [bulbJig.FCStd]
2026-04-29 adjust bulb holder jig
    [bulbJig.FCStd]
2026-05-04 adjust RGB LED bend jig, variation of offsets for bulb jig
    [JigBendLED.FCStd, bulbJig.FCStd]
2026-05-08 Case optimizations (#28)
    * round back edge of casing
    * smooth back corners
    * finalized first batch casings and instructions to print
    [casingPrint2Pieces-bottomCasing17.3mf, casingPrint2Pieces-bottomCasing17.stl, casingPrint2Pieces-topCasing17.3mf, casingPrint2Pieces-topCasing17.stl, casingPrint2Pieces.FCStd]
2026-06-21 Button timing & status-LED behavior rework / DFU util (#29)
    * shorten button timing
    * dfu util flash implementation
    * feat(led): mirror button-press status feedback on front LED
    Route the no-color/locked/shutdown indicators to the front LED in
    addition to the case LED while a button press is being evaluated, so
    bulb-chip builds show lock/shutdown status on the front output.
    - button: take a frontLed and drive its status indicators
    - chip_state/mode_manager: add canUpdateFrontLed gating and enable
    front PWM during button evaluation; run rgbTransientTask on front LED
    - rgb_led: split showColor into balanced vs. unbalanced paths and add
    showTransientColor; show lock/shutdown unbalanced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
    [button.c, chip_state.c, microlight.c, mode_manager.c, rgb_led.c]
